WouterThys/PowerSupply/PCB/MainController/MainController.png

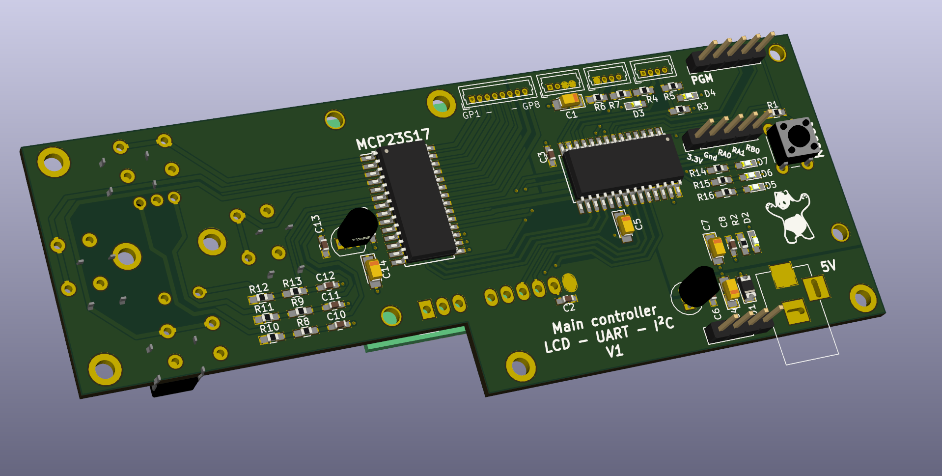
PCB/MainController/MainController.png
