WouterThys/PowerSupply/measurements.ods

 | Rout | 10000 |  |  | Vout divider: |  | 0.198 |  |  |  |  | A Sense: | 20 |  |  |  | All voltages in mV
 |  |  |  |  | Vref: |  | 2.048 |  |  |  |  | R Sense: | 0.1 |  |  |  | All currents in mA
send | dac |  | amp |  | 3081 |  |  |  |  |  | Feedback
 | should be | actual | should be | actual | should be | actual | Imon |  | temp |  | v divider | digital | should be | actual | should be | actual | measure
 |  |  |  |  | Vout |  | measure | calc | measure | calc | V |  |  |  | Iout |  |  |  |  | Values too high for correct working
10 | 20 | 20.6 | 80 | 87.6 | 80 | 522 |  | 0.00 |  |  | 103.36 |  |  | 502 | 0.05 | 0.00
50 | 100 | 100.7 | 400 | 418 | 400 | 537 |  | 0.00 |  |  | 106.33 |  |  | 517 | 0.05 | 0.00
100 | 200 | 201.2 | 800 | 828 | 800 | 828 |  | 0.00 |  |  | 163.94 |  |  | 807 | 0.08 | 0.50 | 2 | 4.6 | Minimum load current needed to operate
200 | 400 | 401 | 1600 | 1634 | 1600 | 1635 |  | 0.00 |  |  | 323.73 |  |  | 1608 | 0.16 | 1.75 | 7 | 7.4
300 | 600 | 602 | 2400 | 2436 | 2400 | 2436 | 0.30 | 0.18 | 490.00 |  | 482.33 |  |  | 2403 | 0.24 | 3.00 | 12 | 9.5
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
