WouterThys/PowerSupply/CalibrationResults.ods

Des | Cal | Cur | Error
400 | 400 | 6 | 0
800 | 800 | 12 | 0
1200 | 1200 | 16 | 0
1600 | 1600 | 20 | 0
2000 | 2000 | 24 | 0
2400 | 2400 | 29 | 0
2800 | 2796 | 33 | 4
3200 | 3196 | 38 | 4
3600 | 3592 | 42 | 8
4000 | 3996 | 46 | 4
