WouterThys/PowerSupply/PCB/V3/MainController.pdf

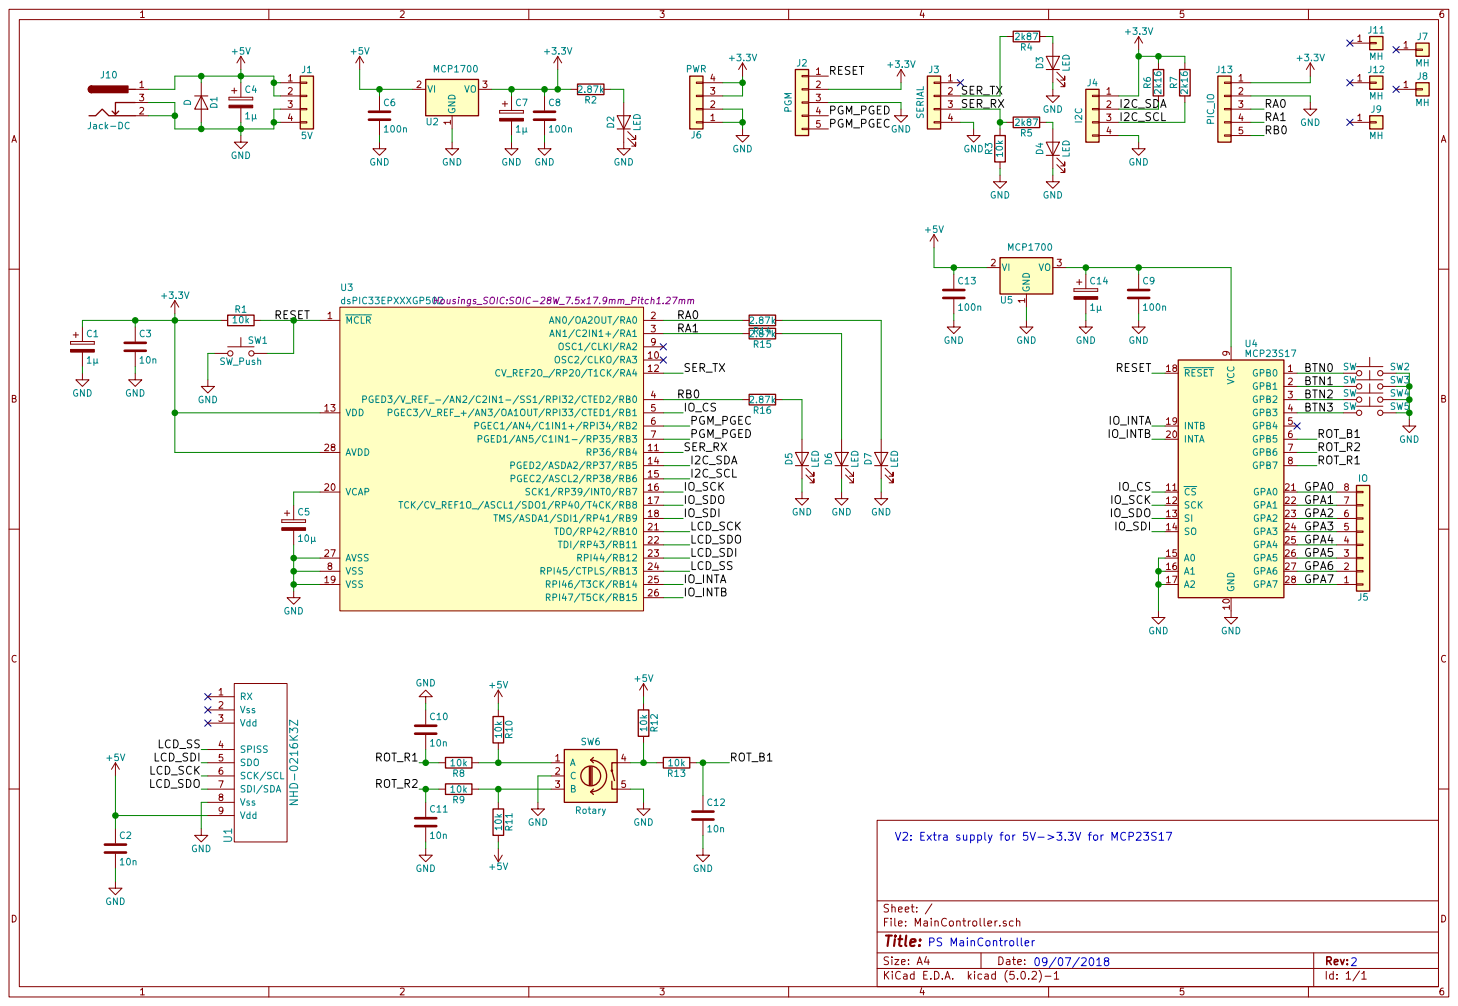
[picture p6: page 1]

Id: 1/1 Title: File: MainController.sch Sheet: /
