WouterThys/PowerSupply/PCB/MainGLCDController/MainGLCDController/MainGLCDController.kicad_pcb

## KiCad design PCB/MainGLCDController/MainGLCDController/MainGLCDController.kicad_pcb (2020-05-08)

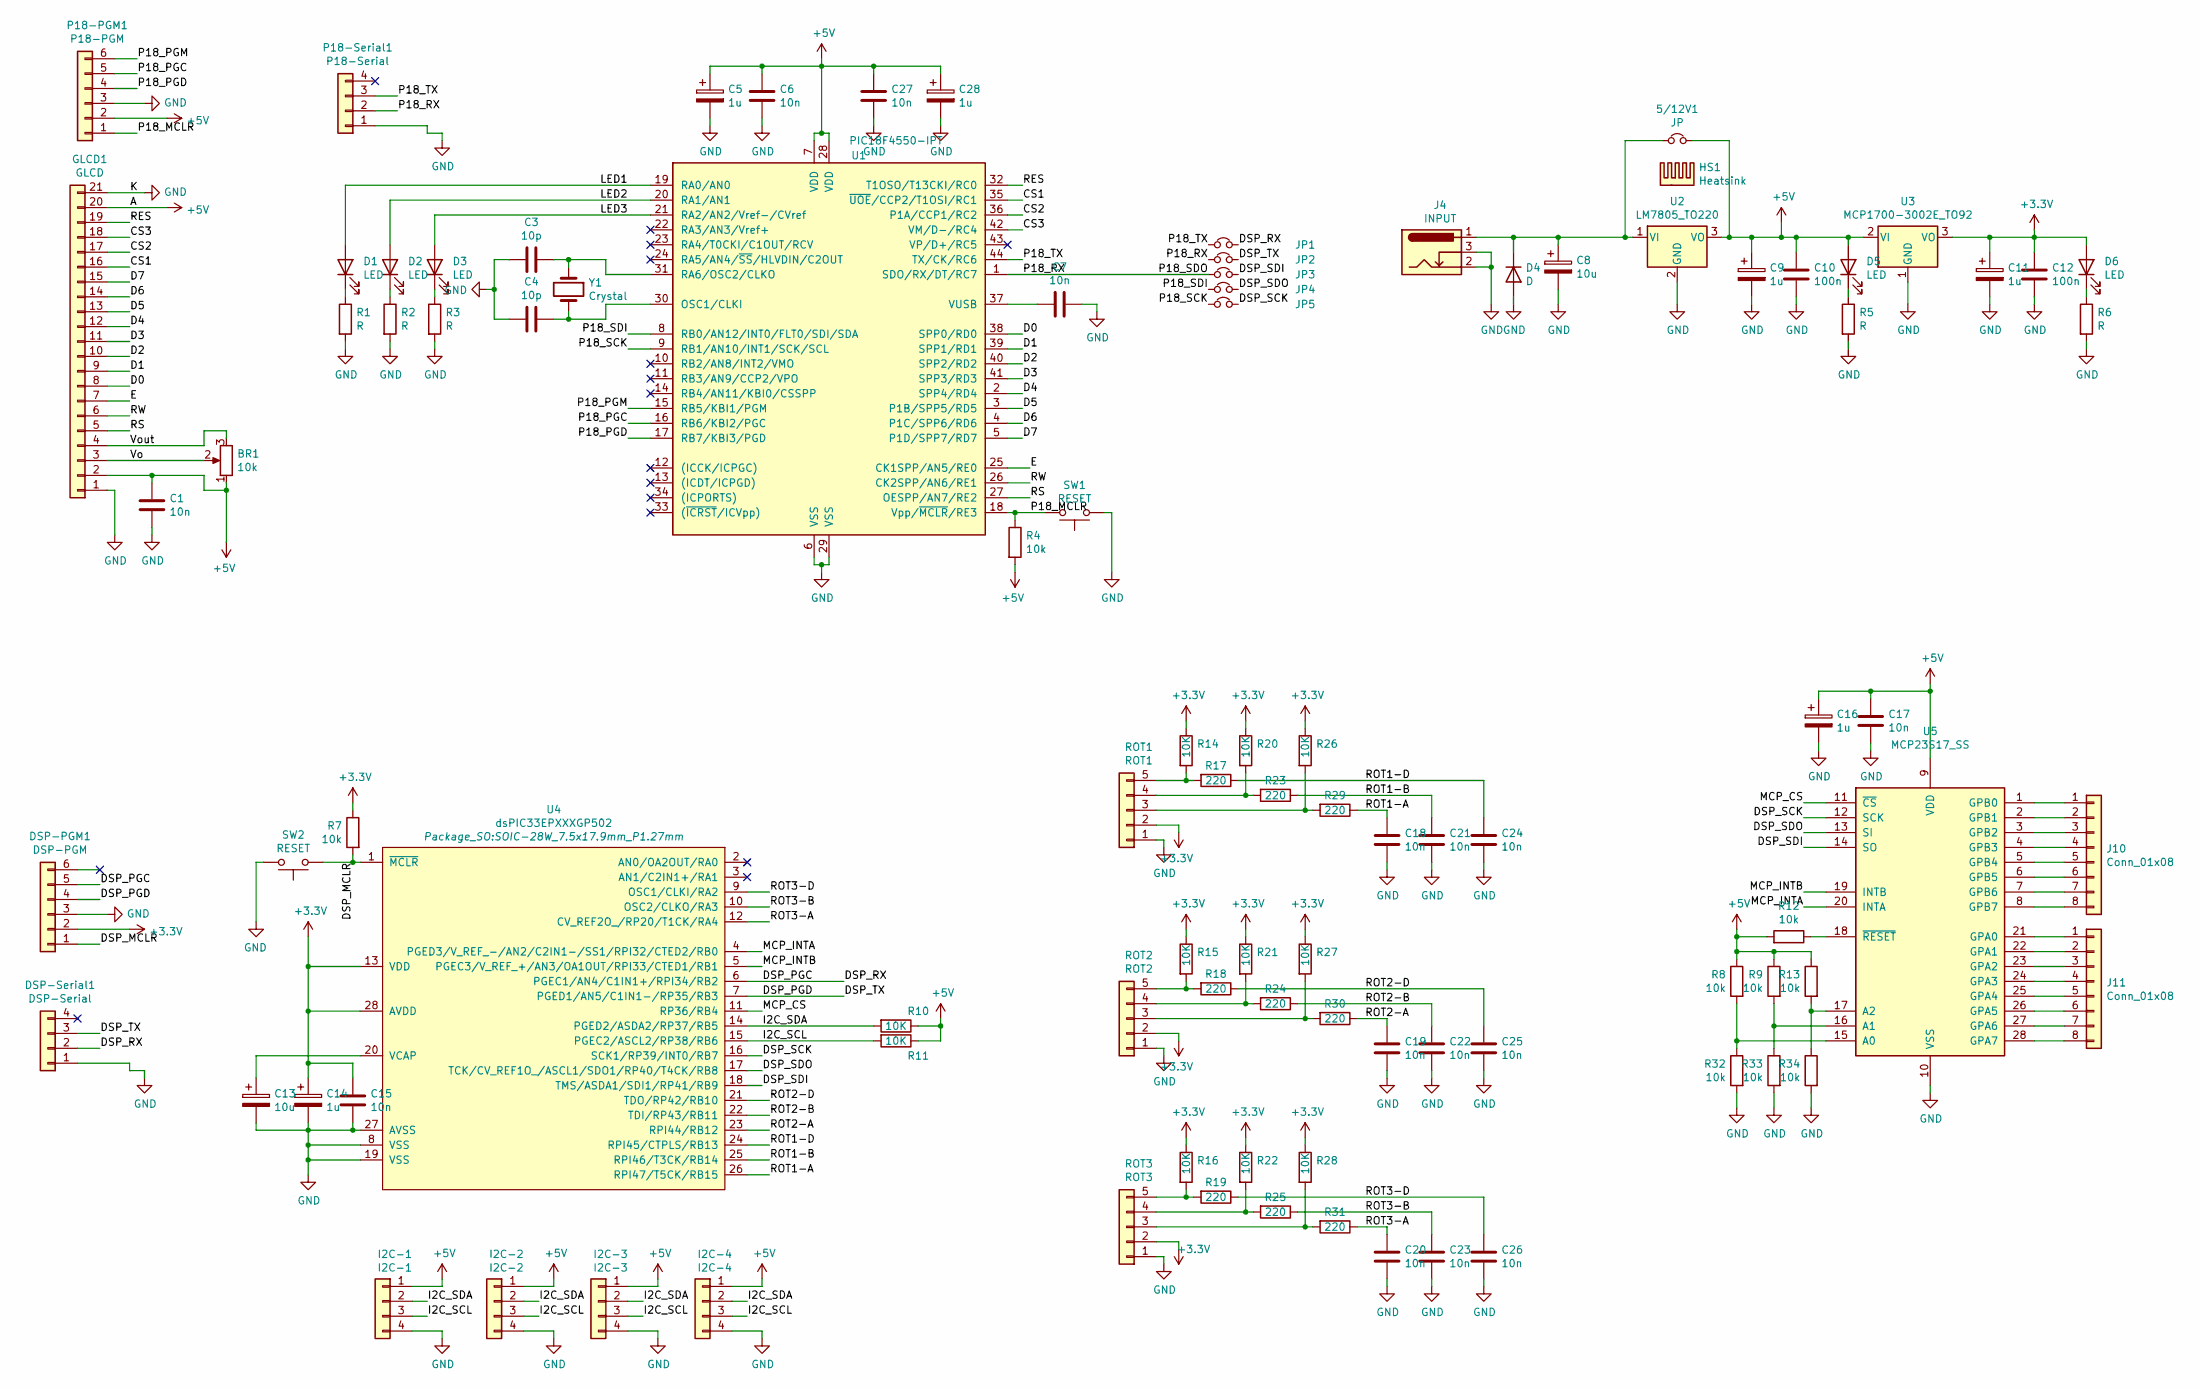
[picture p7: schematic MainGLCDController.sch]

Parts:
5/12V1: JP; PinHeader_1x02_P2.54mm_Vertical
BR1: 10k; Potentiometer_Vishay_T73YP_Vertical
C1, C6, C7, C15, C17, C18, C19, C20, C21, C22, C23, C24, C25, C26, C27: 10n; C_0603_1608Metric_Pad1.05x0.95mm_HandSolder
C3, C4: 10p; C_0603_1608Metric_Pad1.05x0.95mm_HandSolder
C5, C9, C11, C14, C16, C28: 1u; CP_EIA-3216-18_Kemet-A_Pad1.58x1.35mm_HandSolder
C8, C13: 10u; CP_EIA-3216-18_Kemet-A_Pad1.58x1.35mm_HandSolder
C10, C12: 100n; C_0603_1608Metric_Pad1.05x0.95mm_HandSolder
D1, D2, D3, D5, D6: LED; LED_0603_1608Metric_Pad1.05x0.95mm_HandSolder
D4: D; D_DO-15_P12.70mm_Horizontal
DSP-PGM1: DSP-PGM; PinHeader_1x06_P2.54mm_Vertical
DSP-Serial1: DSP-Serial; PinHeader_1x04_P1.27mm_Vertical
GLCD1: GLCD; PinHeader_1x21_P1.27mm_Vertical
HS1: Heatsink; Heatsink_Fischer_SK104-STCB_35x13mm__2xDrill3.5mm_ScrewM3
I2C-1: I2C-1; PinHeader_1x04_P1.27mm_Vertical
I2C-2: I2C-2; PinHeader_1x04_P1.27mm_Vertical
I2C-3: I2C-3; PinHeader_1x04_P1.27mm_Vertical
I2C-4: I2C-4; PinHeader_1x04_P1.27mm_Vertical
J4: INPUT; BarrelJack_Horizontal
J10, J11: Conn_01x08; PinHeader_1x08_P1.27mm_Vertical
JP1, JP2, JP3, JP4, JP5: JP; PinHeader_1x02_P2.54mm_Vertical
P18-PGM1: P18-PGM; PinHeader_1x06_P2.54mm_Vertical
P18-Serial1: P18-Serial; PinHeader_1x04_P1.27mm_Vertical
R1, R2, R3, R5, R6: R; R_0603_1608Metric_Pad1.05x0.95mm_HandSolder
R4, R7, R8, R9, R12, R13, R32, R33, R34: 10k; R_0603_1608Metric_Pad1.05x0.95mm_HandSolder
R10, R11, R14, R15, R16, R20, R21, R22, R26, R27, R28: 10K; R_0603_1608Metric_Pad1.05x0.95mm_HandSolder
R17, R18, R19, R23, R24, R25, R29, R30, R31: 220; R_0603_1608Metric_Pad1.05x0.95mm_HandSolder
ROT1: ROT1; PinHeader_1x05_P1.27mm_Vertical
ROT2: ROT2; PinHeader_1x05_P1.27mm_Vertical
ROT3: ROT3; PinHeader_1x05_P1.27mm_Vertical
SW1, SW2: RESET; SW_PUSH_6mm_H4.3mm
U1: PIC18F4550-IPT; TQFP-44_10x10mm_P0.8mm
U2: LM7805_TO220; TO-220-3_Vertical
U3: MCP1700-3002E_TO92; TO-92_Inline
U4: dsPIC33EPXXXGP502; SOIC-28W_7.5x17.9mm_P1.27mm
U5: MCP23S17_SS; SSOP-28_5.3x10.2mm_P0.65mm
Y1: Crystal; Crystal_HC18-U_Vertical

Connections:
+3V3: C11.1, C12.1, C14.1, C15.1, D6.2 (A), DSP-PGM1.2, R7.1, R14.1, R15.1, R16.1, R20.1, R21.1, R22.1, R26.1, R27.1, R28.1, ROT1.2, ROT2.2, ROT3.2, U3.3 (VO), U4.13 (VDD), U4.28 (AVDD)
+5V: 5/12V1.2, BR1.1, C1.1, C5.1, C6.1, C9.1, C10.1, C16.1, C17.1, C27.1, C28.1, D5.2 (A), GLCD1.2, GLCD1.20, I2C-1.1, I2C-2.1, I2C-3.1, I2C-4.1, P18-PGM1.2, R4.2, R8.1, R9.1, R10.1, R11.1, R12.2, R13.1, U1.7 (VDD), U1.28 (VDD), U2.3 (VO), U3.2 (VI), U5.9 (VDD)
/CS1: GLCD1.16, U1.35 (~UOE~/CCP2/T1OSI/RC1)
/CS2: GLCD1.17, U1.36 (P1A/CCP1/RC2)
/CS3: GLCD1.18, U1.42 (VM/D-/RC4)
/D0: GLCD1.8, U1.38 (SPP0/RD0)
/D1: GLCD1.9, U1.39 (SPP1/RD1)
/D2: GLCD1.10, U1.40 (SPP2/RD2)
/D3: GLCD1.11, U1.41 (SPP3/RD3)
/D4: GLCD1.12, U1.2 (SPP4/RD4)
/D5: GLCD1.13, U1.3 (P1B/SPP5/RD5)
/D6: GLCD1.14, U1.4 (P1C/SPP6/RD6)
/D7: GLCD1.15, U1.5 (P1D/SPP7/RD7)
/DSP_MCLR: DSP-PGM1.1, R7.2, SW2.2, U4.1 (~MCLR)
/DSP_PGC: DSP-PGM1.5, DSP-Serial1.2, JP1.2, U4.6 (PGEC1/AN4/C1IN1+/RPI34/RB2)
/DSP_PGD: DSP-PGM1.4, DSP-Serial1.3, JP2.2, U4.7 (PGED1/AN5/C1IN1-/RP35/RB3)
/DSP_SCK: JP5.2, U4.16 (SCK1/RP39/INT0/RB7), U5.12 (SCK)
/DSP_SDI: JP3.2, U4.18 (TMS/ASDA1/SDI1/RP41/RB9), U5.14 (SO)
/DSP_SDO: JP4.2, U4.17 (TCK/CV_REF1O_/ASCL1/SDO1/RP40/T4CK/RB8), U5.13 (SI)
/E: GLCD1.7, U1.25 (CK1SPP/AN5/RE0)
/I2C_SCL: I2C-1.3, I2C-2.3, I2C-3.3, I2C-4.3, R11.2, U4.15 (PGEC2/ASCL2/RP38/RB6)
/I2C_SDA: I2C-1.2, I2C-2.2, I2C-3.2, I2C-4.2, R10.2, U4.14 (PGED2/ASDA2/RP37/RB5)
/LED1: D1.2 (A), U1.19 (RA0/AN0)
/LED2: D2.2 (A), U1.20 (RA1/AN1)
/LED3: D3.2 (A), U1.21 (RA2/AN2/Vref-/CVref)
/MCP_CS: U4.11 (RP36/RB4), U5.11 (~CS~)
/MCP_INTA: U4.4 (PGED3/V_REF_-/AN2/C2IN1-/SS1/RPI32/CTED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), U5.20 (INTA)
/MCP_INTB: U4.5 (PGEC3/V_REF_+/AN3/OA1OUT/RPI33/CTED1/RB1), U5.19 (INTB)
/P18_MCLR: P18-PGM1.1, R4.1, SW1.2, U1.18 (Vpp/~MCLR~/RE3)
/P18_PGC: P18-PGM1.5, U1.16 (RB6/KBI2/PGC)
/P18_PGD: P18-PGM1.4, U1.17 (RB7/KBI3/PGD)
/P18_PGM: P18-PGM1.6, U1.15 (RB5/KBI1/PGM)
/P18_RX: JP2.1, JP3.1, P18-Serial1.2, U1.1 (SDO/RX/DT/RC7)
/P18_SCK: JP5.1, U1.9 (RB1/AN10/INT1/SCK/SCL)
/P18_SDI: JP4.1, U1.8 (RB0/AN12/INT0/FLT0/SDI/SDA)
/P18_TX: JP1.1, P18-Serial1.3, U1.44 (TX/CK/RC6)
/RES: GLCD1.19, U1.32 (T1OSO/T13CKI/RC0)
/ROT1-A: C18.1, R29.1, U4.26 (RPI47/T5CK/RB15)
/ROT1-B: C21.1, R23.1, U4.25 (RPI46/T3CK/RB14)
/ROT1-D: C24.1, R17.1, U4.24 (RPI45/CTPLS/RB13)
/ROT2-A: C19.1, R30.1, U4.23 (RPI44/RB12)
/ROT2-B: C22.1, R24.1, U4.22 (TDI/RP43/RB11)
/ROT2-D: C25.1, R18.1, U4.21 (TDO/RP42/RB10)
/ROT3-A: C20.1, R31.1, U4.12 (CV_REF2O_/RP20/T1CK/RA4)
/ROT3-B: C23.1, R25.1, U4.10 (OSC2/CLKO/RA3)
/ROT3-D: C26.1, R19.1, U4.9 (OSC1/CLKI/RA2)
/RS: GLCD1.5, U1.27 (OESPP/AN7/RE2)
/RW: GLCD1.6, U1.26 (CK2SPP/AN6/RE1)
/Vo: BR1.2, GLCD1.3
/Vout: BR1.3, GLCD1.4
GND: C1.2, C3.2, C4.2, C5.2, C6.2, C7.1, C8.2, C9.2, C10.2, C11.2, C12.2, C13.2, C14.2, C15.2, C16.2, C17.2, C18.2, C19.2, C20.2, C21.2, C22.2, C23.2, C24.2, C25.2, C26.2, C27.2, C28.2, D4.2 (A), DSP-PGM1.3, DSP-Serial1.1, GLCD1.1, GLCD1.21, I2C-1.4, I2C-2.4, I2C-3.4, I2C-4.4, J4.2, J4.3, P18-PGM1.3, P18-Serial1.1, R1.2, R2.2, R3.2, R5.2, R6.2, R32.2, R33.2, R34.2, ROT1.1, ROT2.1, ROT3.1, SW1.1, SW2.1, U1.6 (VSS), U1.29 (VSS), U2.2 (GND), U3.1 (GND), U4.8 (VSS), U4.19 (VSS), U4.27 (AVSS), U5.10 (VSS)
unnamed: 5/12V1.1, C8.1, D4.1 (K), J4.1, U2.1 (VI)
unnamed: C3.1, U1.31 (RA6/OSC2/CLKO), Y1.1
unnamed: C4.1, U1.30 (OSC1/CLKI), Y1.2
unnamed: C7.2, U1.37 (VUSB)
unnamed: C13.1, U4.20 (VCAP)
unnamed: D1.1 (K), R1.1
unnamed: D2.1 (K), R2.1
unnamed: D3.1 (K), R3.1
unnamed: D5.1 (K), R5.1
unnamed: D6.1 (K), R6.1
unnamed: J10.1, U5.1 (GPB0)
unnamed: J10.2, U5.2 (GPB1)
unnamed: J10.3, U5.3 (GPB2)
unnamed: J10.4, U5.4 (GPB3)
unnamed: J10.5, U5.5 (GPB4)
unnamed: J10.6, U5.6 (GPB5)
unnamed: J10.7, U5.7 (GPB6)
unnamed: J10.8, U5.8 (GPB7)
unnamed: J11.1, U5.21 (GPA0)
unnamed: J11.2, U5.22 (GPA1)
unnamed: J11.3, U5.23 (GPA2)
unnamed: J11.4, U5.24 (GPA3)
unnamed: J11.5, U5.25 (GPA4)
unnamed: J11.6, U5.26 (GPA5)
unnamed: J11.7, U5.27 (GPA6)
unnamed: J11.8, U5.28 (GPA7)
unnamed: R12.1, U5.18 (~RESET~)
unnamed: R13.2, R34.1, U5.17 (A2)
unnamed: R14.2, R17.2, ROT1.5
unnamed: R15.2, R18.2, ROT2.5
unnamed: R16.2, R19.2, ROT3.5
unnamed: R20.2, R23.2, ROT1.4
unnamed: R21.2, R24.2, ROT2.4
unnamed: R22.2, R25.2, ROT3.4
unnamed: R26.2, R29.2, ROT1.3
unnamed: R27.2, R30.2, ROT2.3
unnamed: R28.2, R31.2, ROT3.3
unnamed: R8.2, R32.1, U5.15 (A0)
unnamed: R9.2, R33.1, U5.16 (A1)

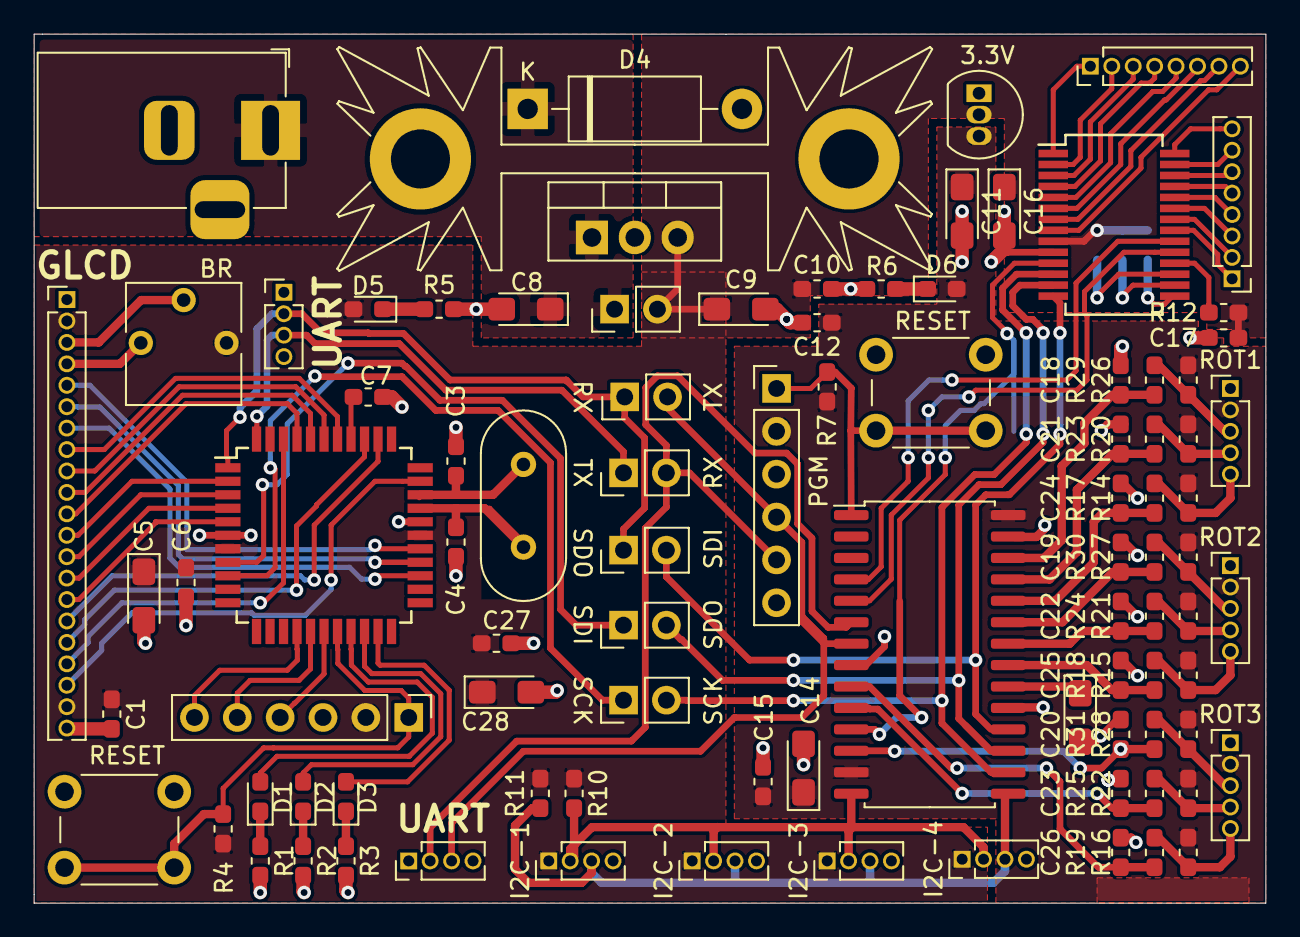
[picture p8: board MainGLCDController.kicad_pcb from above]

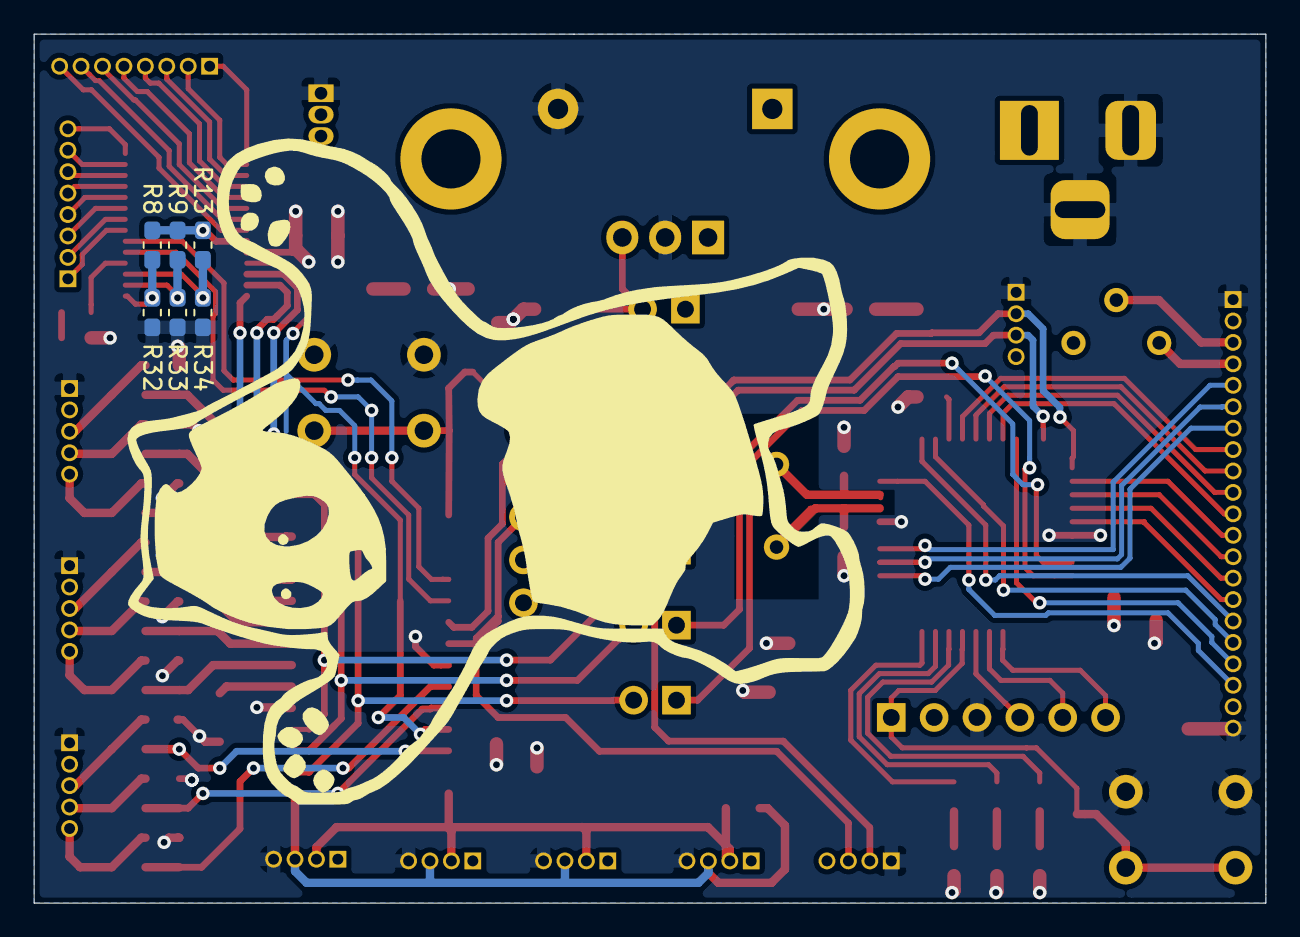
[picture p9: board MainGLCDController.kicad_pcb from below]

Board: 2 copper layers, 73.0 x 51.5 mm, 98 parts (6 on the bottom side), 90 nets.
