WouterThys/PowerSupply/PCB/MainController/MainController.kicad_pcb

## KiCad design PCB/MainController/MainController.kicad_pcb (2018-07-30)

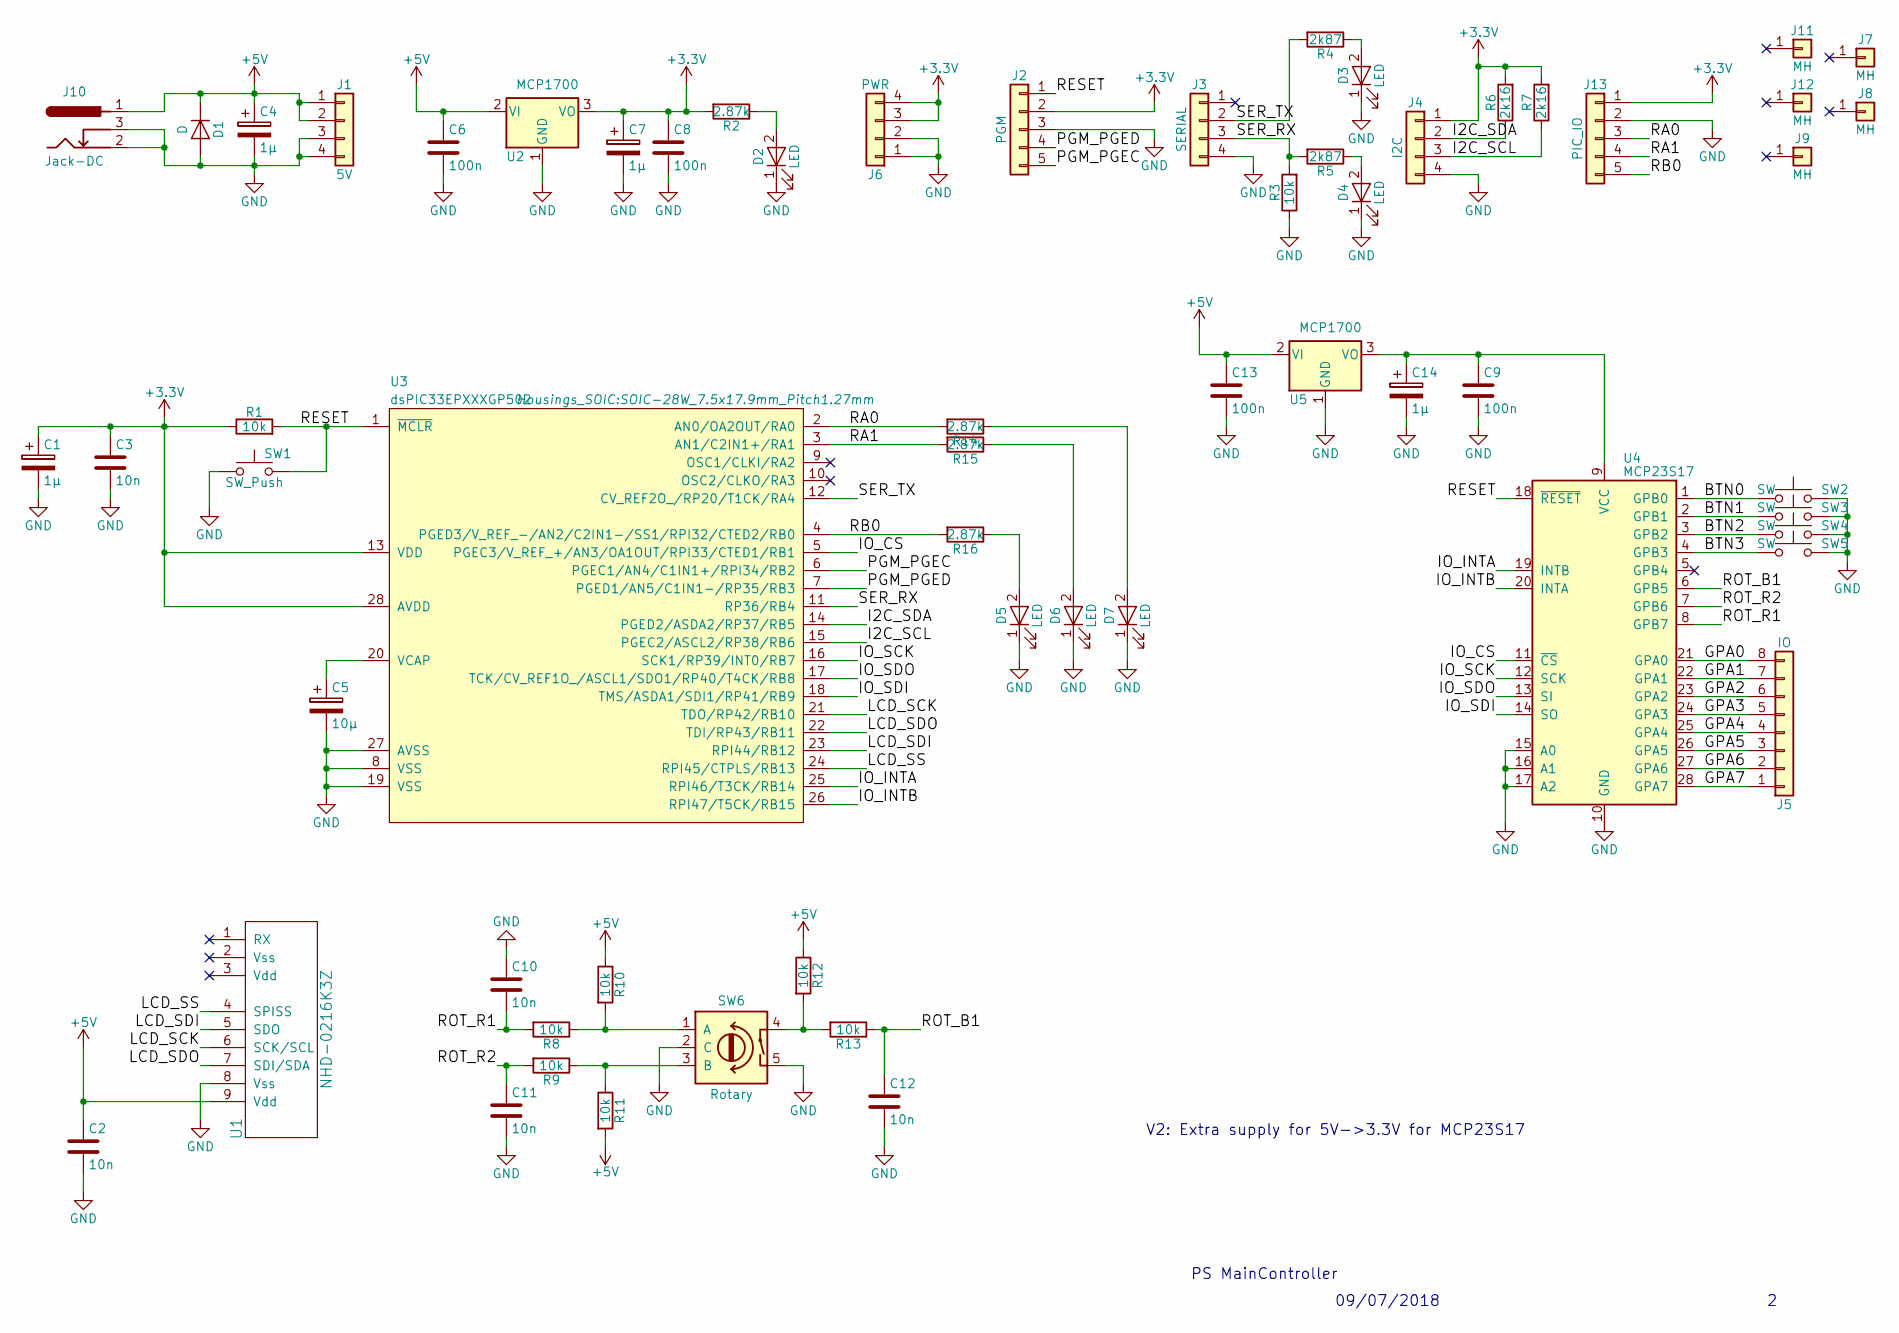
[picture p10: schematic MainController.sch]

Parts:
C1, C4, C7, C14: 1µ; CP_Tantalum_Case-A_EIA-3216-18_Reflow
C2, C3, C10, C11, C12: 10n; C_0603_HandSoldering
C5: 10µ; CP_Tantalum_Case-A_EIA-3216-18_Reflow
C6, C8, C9, C13: 100n; C_0603_HandSoldering
D1: D; D_1206
D2, D3, D4, D5, D6, D7: LED; LED_0603_HandSoldering
J1: 5V; Pin_Header_Straight_1x04_Pitch2.54mm
J2: PGM; Pin_Header_Straight_1x05_Pitch2.54mm
J3: SERIAL; Molex_PicoBlade_53047-0410_04x1.25mm_Straight
J4: I2C; Molex_PicoBlade_53047-0410_04x1.25mm_Straight
J5: IO; Molex_PicoBlade_53047-0810_08x1.25mm_Straight
J6: PWR; Molex_PicoBlade_53047-0410_04x1.25mm_Straight
J7, J8, J9, J11, J12: MH; MountingHole_2.7mm_M2.5_ISO14580_Pad
J10: Jack-DC; BARREL_JACK
J13: PIC_IO; Pin_Header_Straight_1x05_Pitch2.54mm
R1, R3, R8, R9, R10, R11, R12, R13: 10k; R_0603_HandSoldering
R2, R14, R15, R16: 2.87k; R_0603_HandSoldering
R4, R5: 2k87; R_0603_HandSoldering
R6, R7: 2k16; R_0603_HandSoldering
SW1: SW_Push; SW_PUSH_6mm
SW2, SW3, SW4, SW5: SW; mySW_PUSH_6mm
SW6: Rotary; ALPS_STEC12E08
U1: NHD-0216K3Z; WC1602A
U2, U5: MCP1700; TO-92_Inline_Narrow_Oval
U3: dsPIC33EPXXXGP502; SOIC-28W_7.5x17.9mm_Pitch1.27mm
U4: MCP23S17; SOIC-28W_7.5x17.9mm_Pitch1.27mm

Connections:
+3V3: C1.1, C3.1, C7.1, C8.1, J2.2, J4.1, J6.3, J6.4, J13.1, R1.1, R2.2, R6.2, R7.2, U2.3 (VO), U3.13 (VDD), U3.28 (AVDD)
+5V: C2.1, C4.1, C6.1, C13.1, D1.1 (K), J1.1, J1.2, J10.1, R10.1, R11.2, R12.1, U1.9 (Vdd), U2.2 (VI), U5.2 (VI)
/BTN0: SW2.1, U4.1 (GPB0)
/BTN1: SW3.1, U4.2 (GPB1)
/BTN2: SW4.1, U4.3 (GPB2)
/BTN3: SW5.1, U4.4 (GPB3)
/GPA0: J5.8, U4.21 (GPA0)
/GPA1: J5.7, U4.22 (GPA1)
/GPA2: J5.6, U4.23 (GPA2)
/GPA3: J5.5, U4.24 (GPA3)
/GPA4: J5.4, U4.25 (GPA4)
/GPA5: J5.3, U4.26 (GPA5)
/GPA6: J5.2, U4.27 (GPA6)
/GPA7: J5.1, U4.28 (GPA7)
/I2C_SCL: J4.3, R7.1, U3.15 (PGEC2/ASCL2/RP38/RB6)
/I2C_SDA: J4.2, R6.1, U3.14 (PGED2/ASDA2/RP37/RB5)
/IO_CS: U3.5 (PGEC3/V_REF_+/AN3/OA1OUT/RPI33/CTED1/RB1), U4.11 (~CS)
/IO_INTA: U3.25 (RPI46/T3CK/RB14), U4.19 (INTB)
/IO_INTB: U3.26 (RPI47/T5CK/RB15), U4.20 (INTA)
/IO_SCK: U3.16 (SCK1/RP39/INT0/RB7), U4.12 (SCK)
/IO_SDI: U3.18 (TMS/ASDA1/SDI1/RP41/RB9), U4.14 (SO)
/IO_SDO: U3.17 (TCK/CV_REF1O_/ASCL1/SDO1/RP40/T4CK/RB8), U4.13 (SI)
/LCD_SCK: U1.6 (SCK/SCL), U3.21 (TDO/RP42/RB10)
/LCD_SDI: U1.5 (SDO), U3.23 (RPI44/RB12)
/LCD_SDO: U1.7 (SDI/SDA), U3.22 (TDI/RP43/RB11)
/LCD_SS: U1.4 (SPISS), U3.24 (RPI45/CTPLS/RB13)
/PGM_PGEC: J2.5, U3.6 (PGEC1/AN4/C1IN1+/RPI34/RB2)
/PGM_PGED: J2.4, U3.7 (PGED1/AN5/C1IN1-/RP35/RB3)
/RA0: J13.3, R14.2, U3.2 (AN0/OA2OUT/RA0)
/RA1: J13.4, R15.2, U3.3 (AN1/C2IN1+/RA1)
/RB0: J13.5, R16.2, U3.4 (PGED3/V_REF_-/AN2/C2IN1-/SS1/RPI32/CTED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)
/RESET: J2.1, R1.2, SW1.2, U3.1 (~MCLR), U4.18 (~RESET)
/ROT_B1: C12.1, R13.1, U4.6 (GPB5)
/ROT_R1: C10.2, R8.2, U4.8 (GPB7)
/ROT_R2: C11.1, R9.2, U4.7 (GPB6)
/SER_RX: J3.3, R3.2, R5.2, U3.11 (RP36/RB4)
/SER_TX: J3.2, R4.2, U3.12 (CV_REF2O_/RP20/T1CK/RA4)
GND: C1.2, C2.2, C3.2, C4.2, C5.2, C6.2, C7.2, C8.2, C9.2, C10.1, C11.2, C12.2, C13.2, C14.2, D1.2 (A), D2.1 (K), D3.1 (K), D4.1 (K), D5.1 (K), D6.1 (K), D7.1 (K), J1.3, J1.4, J2.3, J3.4, J4.4, J6.1, J6.2, J10.2, J10.3, J13.2, R3.1, SW1.1, SW2.2, SW3.2, SW4.2, SW5.2, SW6.2 (C), SW6.5, U1.8 (Vss), U2.1 (GND), U3.8 (VSS), U3.19 (VSS), U3.27 (AVSS), U4.10 (GND), U4.15 (A0), U4.16 (A1), U4.17 (A2), U5.1 (GND)
unnamed: C5.1, U3.20 (VCAP)
unnamed: C9.1, C14.1, U4.9 (VCC), U5.3 (VO)
unnamed: D2.2 (A), R2.1
unnamed: D3.2 (A), R4.1
unnamed: D4.2 (A), R5.1
unnamed: D5.2 (A), R16.1
unnamed: D6.2 (A), R15.1
unnamed: D7.2 (A), R14.1
unnamed: R8.1, R10.2, SW6.1 (A)
unnamed: R9.1, R11.1, SW6.3 (B)
unnamed: R12.2, R13.2, SW6.4

Notes on the sheet:
V2: Extra supply for 5V->3.3V for MCP23S17
PS MainController
09/07/2018

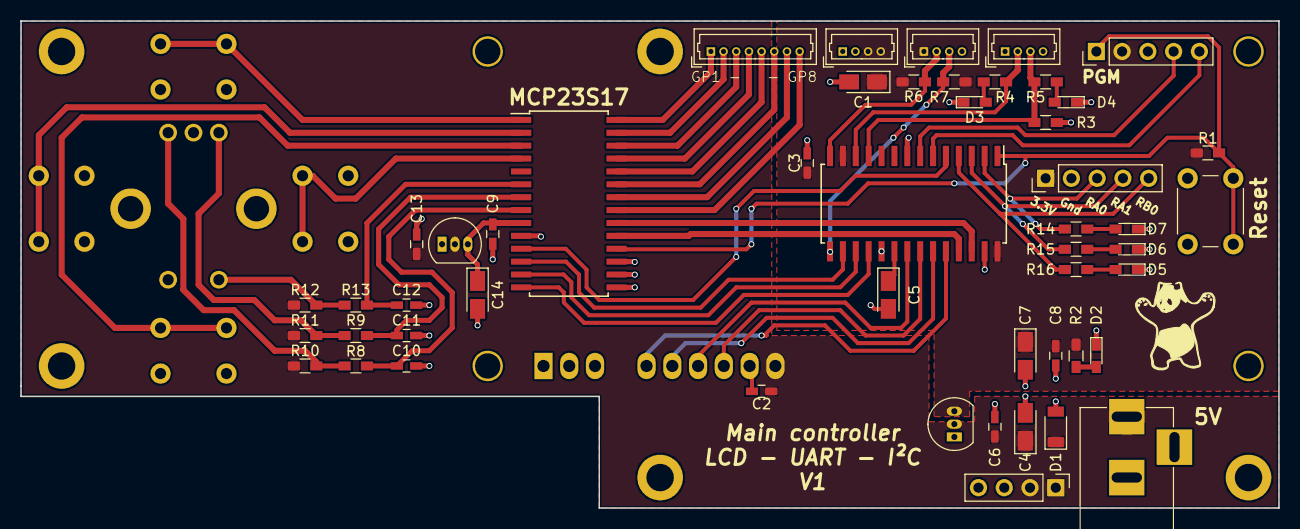
[picture p11: board MainController.kicad_pcb from above]

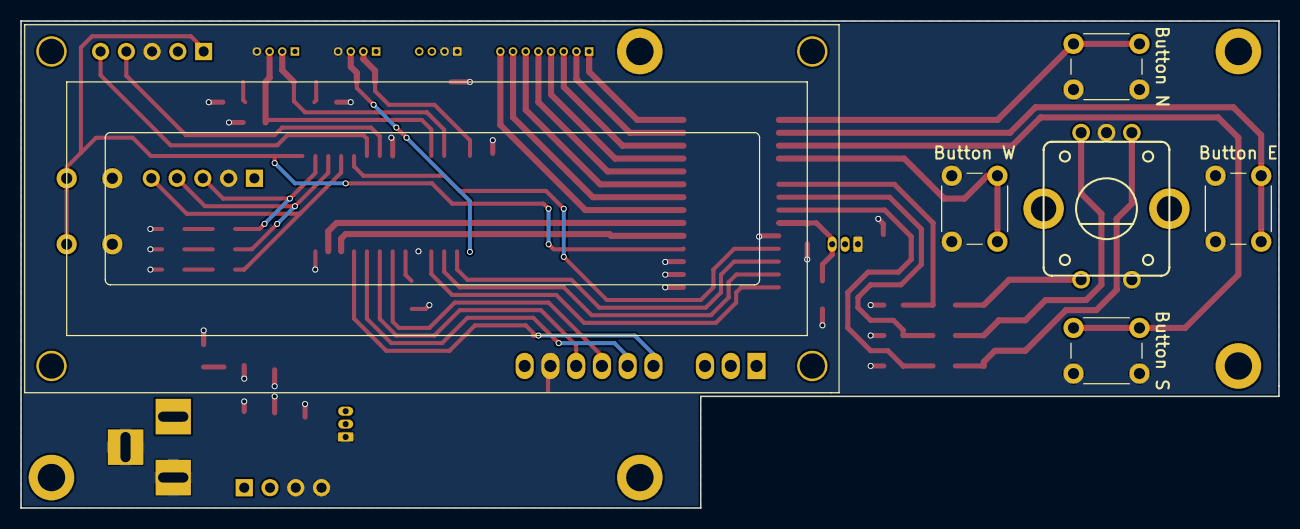
[picture p12: board MainController.kicad_pcb from below]

Board: 2 copper layers, 124.0 x 48.0 mm, 61 parts (6 on the bottom side), 49 nets.
