WouterThys/PowerSupply/PCB/V1/SupplyMainDigital.kicad_pcb

## KiCad design PCB/V1/SupplyMainDigital.kicad_pcb (2018-06-11, an earlier design)

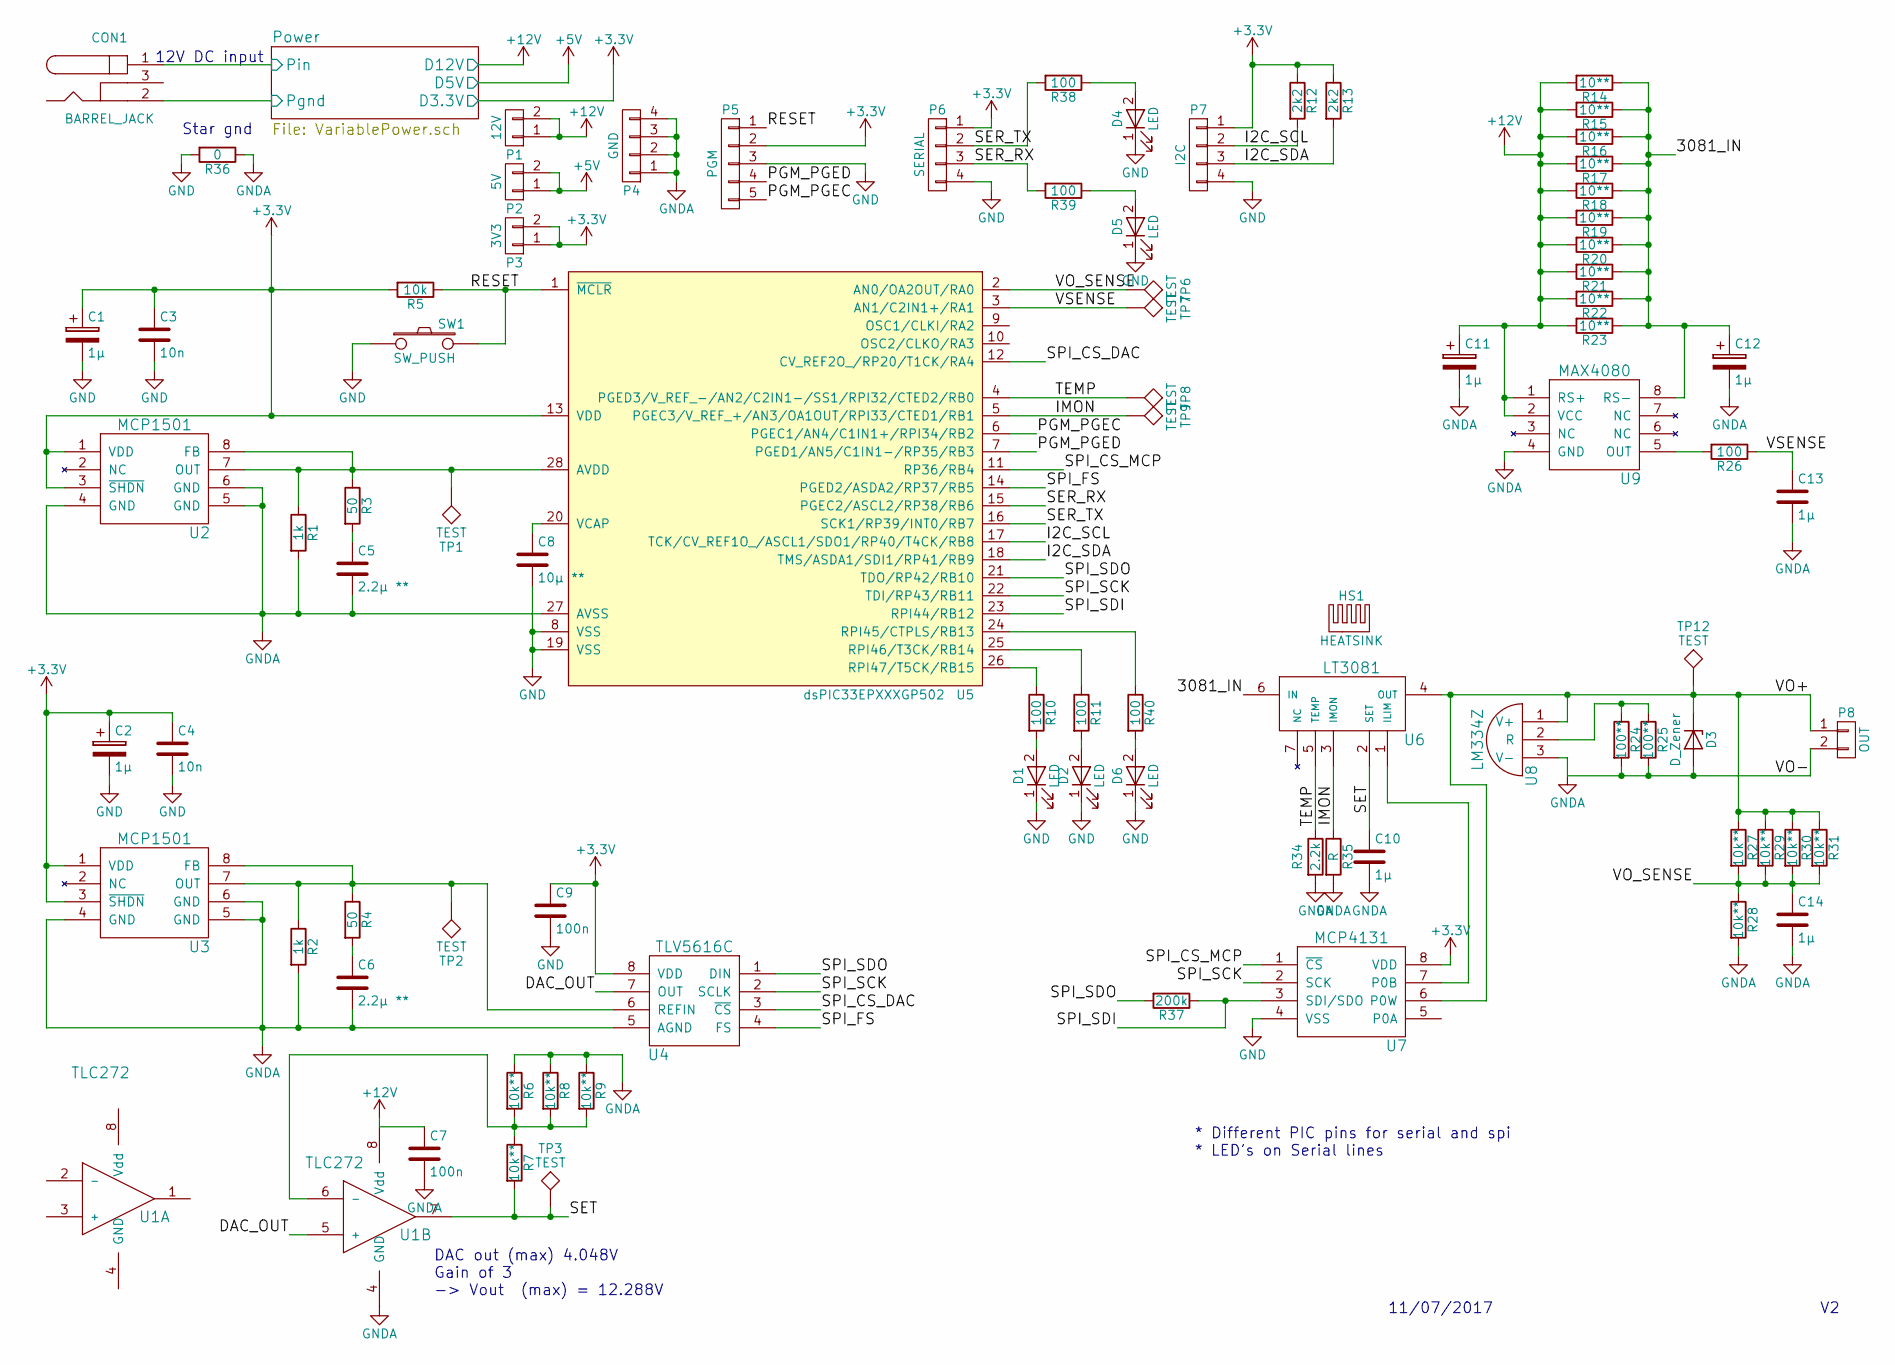
[picture p13: schematic SupplyMainDigital.sch]

Parts:
C1, C2, C10, C11, C12, C13, C14: 1µ; C_0603_HandSoldering
C3, C4: 10n; C_0603_HandSoldering
C5, C6: 2.2µ **; CP_Tantalum_Case-A_EIA-3216-18_Reflow
C7, C9: 100n; C_0603_HandSoldering
C8: 10µ **; CP_Tantalum_Case-A_EIA-3216-18_Reflow
CON1: BARREL_JACK
D1, D2, D4, D5, D6: LED; LED_0603
D3: D_Zener; D_5W_P10.16mm_Horizontal
HS1: HEATSINK; Heatsink_Fischer_SK104-STCB_35x13mm__2xDrill3.5mm_ScrewM3
P1: 12V; Pin_Header_Straight_1x02_Pitch2.54mm
P2: 5V; Pin_Header_Straight_1x02_Pitch2.54mm
P3: 3V3; Pin_Header_Straight_1x02_Pitch2.54mm
P4: GND; Pin_Header_Straight_1x04_Pitch2.54mm
P5: PGM; Pin_Header_Angled_1x05_Pitch2.00mm
P6: SERIAL; Molex_PicoBlade_53047-0410_04x1.25mm_Straight
P7: I2C; Molex_PicoBlade_53047-0410_04x1.25mm_Straight
P8: OUT; AK300-2
R1, R2: 1k; R_0603_HandSoldering
R3, R4: 50; R_0603_HandSoldering
R5: 10k; R_0603_HandSoldering
R6, R7, R8, R9, R27, R28, R29, R30, R31: 10k**; R_0603_HandSoldering
R10, R11, R26, R38, R39, R40: 100; R_0603_HandSoldering
R12, R13: 2k2; R_0603_HandSoldering
R14, R15, R16, R17, R18, R19, R20, R21, R22, R23: 10**; R_0805_HandSoldering
R24, R25: 100**; R_0603_HandSoldering
R34: 2.2k; R_0603_HandSoldering
R35: R; R_0603_HandSoldering
R36: 0; R_0603_HandSoldering
R37: 200k; R_0603_HandSoldering
SW1: SW_PUSH; SW_SPST_B3S-1000
TP1, TP2, TP3, TP6, TP7, TP8, TP9, TP12: TEST; Measurement_Point_Round-SMD-Pad_Small
U1: TLC272; TSSOP-8_4.4x3mm_Pitch0.65mm
U2, U3: MCP1501; SOIC-8_3.9x4.9mm_Pitch1.27mm
U4: TLV5616C; SOIC-8_3.9x4.9mm_Pitch1.27mm
U5: dsPIC33EPXXXGP502; SOIC-28W_7.5x17.9mm_Pitch1.27mm
U6: LT3081; TO-220-7_Multiwatt-7_Vertical_StaggeredType1
U7: MCP4131; MSOP-8_3x3mm_Pitch0.65mm
U8: LM334Z; TO-92_Inline_Narrow_Oval
U9: MAX4080; MSOP-8_3x3mm_Pitch0.65mm

Connections:
+3V3: C1.1, C2.1, C3.1, C4.1, C9.1, P3.1, P3.2, P5.2, P6.1, P7.1, R5.2, R12.1, R13.1, U2.1 (VDD), U2.3 (~SHDN), U3.1 (VDD), U3.3 (~SHDN), U4.8 (VDD), U5.13 (VDD), U7.8 (VDD); also elsewhere on the board
+5V: P2.1, P2.2; also elsewhere on the board
+12V: C7.1, C11.1, P1.1, P1.2, R14.2, R15.2, R16.2, R17.2, R18.2, R19.2, R20.2, R21.2, R22.2, R23.2, U1.8 (Vdd), U9.1 (RS+), U9.2 (VCC); also elsewhere on the board
/3081_IN: C12.1, R14.1, R15.1, R16.1, R17.1, R18.1, R19.1, R20.1, R21.1, R22.1, R23.1, U6.6 (IN), U9.8 (RS-)
/DAC_OUT: U1.5 (+), U4.7 (OUT)
/I2C_SCL: P7.2, R12.2, U5.17 (TCK/CV_REF1O_/ASCL1/SDO1/RP40/T4CK/RB8)
/I2C_SDA: P7.3, R13.2, U5.18 (TMS/ASDA1/SDI1/RP41/RB9)
/IMON: R35.1, TP9.1, U5.5 (PGEC3/V_REF_+/AN3/OA1OUT/RPI33/CTED1/RB1), U6.3 (IMON)
/PGM_PGEC: P5.5, U5.6 (PGEC1/AN4/C1IN1+/RPI34/RB2)
/PGM_PGED: P5.4, U5.7 (PGED1/AN5/C1IN1-/RP35/RB3)
/Power/Pin: CON1.1; also elsewhere on the board
/RESET: P5.1, R5.1, SW1.2, U5.1 (~MCLR)
/SER_RX: P6.3, R39.2, U5.15 (PGEC2/ASCL2/RP38/RB6)
/SER_TX: P6.2, R38.2, U5.16 (SCK1/RP39/INT0/RB7)
/SET: C10.1, R7.2, TP3.1, U1.7, U6.2 (SET)
/SPI_CS_DAC: U4.3 (~CS), U5.12 (CV_REF2O_/RP20/T1CK/RA4)
/SPI_CS_MCP: U5.11 (RP36/RB4), U7.1 (~CS)
/SPI_FS: U4.4 (FS), U5.14 (PGED2/ASDA2/RP37/RB5)
/SPI_SCK: U4.2 (SCLK), U5.22 (TDI/RP43/RB11), U7.2 (SCK)
/SPI_SDI: R37.1, U5.23 (RPI44/RB12), U7.3 (SDI/SDO)
/SPI_SDO: R37.2, U4.1 (DIN), U5.21 (TDO/RP42/RB10)
/TEMP: R34.1, TP8.1, U5.4 (PGED3/V_REF_-/AN2/C2IN1-/SS1/RPI32/CTED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), U6.5 (TEMP)
/VO+: D3.1 (K), P8.1, R27.1, R29.1, R30.1, R31.1, TP12.1, U6.4 (OUT), U7.6 (P0W), U8.1 (V+)
/VO_SENSE: C14.1, R27.2, R28.1, R29.2, R30.2, R31.2, TP6.1, U5.2 (AN0/OA2OUT/RA0)
/VSENSE: C13.1, R26.1, TP7.1, U5.3 (AN1/C2IN1+/RA1)
GND: C1.2, C2.2, C3.2, C4.2, C8.2, C9.2, D1.1 (K), D2.1 (K), D4.1 (K), D5.1 (K), D6.1 (K), P5.3, P6.4, P7.4, R36.2, SW1.1, U5.8 (VSS), U5.19 (VSS), U7.4 (VSS)
GNDA: C5.2, C6.2, C7.2, C10.2, C11.2, C12.2, C13.2, C14.2, CON1.2, D3.2 (A), P4.1, P4.2, P4.3, P4.4, P8.2, R1.2, R2.2, R6.1, R8.1, R9.1, R24.2, R25.2, R28.2, R34.2, R35.2, R36.1, U1.4 (GND), U2.4 (GND), U2.5 (GND), U2.6 (GND), U3.4 (GND), U3.5 (GND), U3.6 (GND), U4.5 (AGND), U5.27 (AVSS), U8.3 (V-), U9.4 (GND); also elsewhere on the board
unnamed: C5.1, R3.2
unnamed: C6.1, R4.2
unnamed: C8.1, U5.20 (VCAP)
unnamed: D1.2 (A), R10.2
unnamed: D2.2 (A), R11.2
unnamed: D4.2 (A), R38.1
unnamed: D5.2 (A), R39.1
unnamed: D6.2 (A), R40.2
unnamed: R1.1, R3.1, TP1.1, U2.7 (OUT), U2.8 (FB), U5.28 (AVDD)
unnamed: R2.1, R4.1, TP2.1, U3.7 (OUT), U3.8 (FB), U4.6 (REFIN)
unnamed: R6.2, R7.1, R8.2, R9.2, U1.6 (-)
unnamed: R10.1, U5.26 (RPI47/T5CK/RB15)
unnamed: R11.1, U5.25 (RPI46/T3CK/RB14)
unnamed: R24.1, R25.1, U8.2 (R)
unnamed: R26.2, U9.5 (OUT)
unnamed: R40.1, U5.24 (RPI45/CTPLS/RB13)
unnamed: U6.1 (ILIM), U7.7 (P0B)

Notes on the sheet:
DAC out (max) 4.048V Gain of 3 -> Vout (max) = 12.288V
Star gnd
11/07/2017
* Different PIC pins for serial and spi * LED's on Serial lines
12V DC input

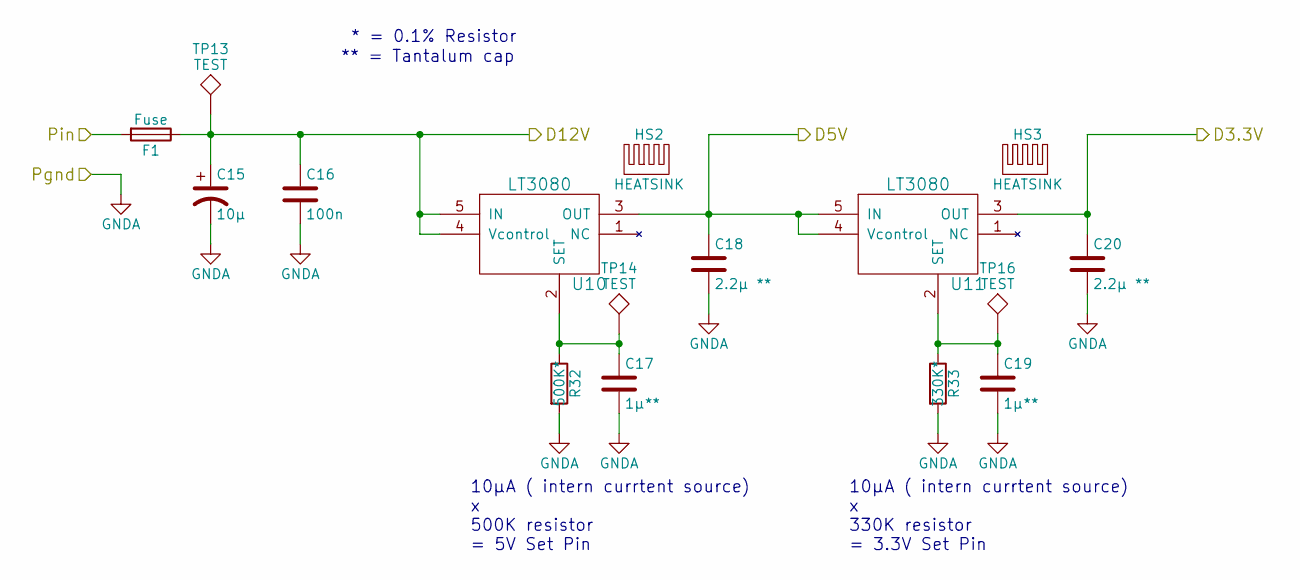
[picture p14: schematic VariablePower.sch]

Parts:
C15: 10µ; C_0603_HandSoldering
C16: 100n; C_0603_HandSoldering
C17, C19: 1µ**; CP_Tantalum_Case-A_EIA-3216-18_Reflow
C18, C20: 2.2µ **; CP_Tantalum_Case-A_EIA-3216-18_Reflow
F1: Fuse; Fuseholder5x20_horiz_SemiClosed_Casing10x25mm
HS2, HS3: HEATSINK; Heatsink_Fischer_SK104-STCB_35x13mm__2xDrill3.5mm_ScrewM3
R32: 500K*; R_0603_HandSoldering
R33: 330K*; R_0603_HandSoldering
TP13, TP14, TP16: TEST; Measurement_Point_Round-SMD-Pad_Small
U10, U11: LT3080; TO-220-5_Pentawatt_Multiwatt-5_Vertical_StaggeredType1

Connections:
+3V3: C20.1, U11.3 (OUT); also elsewhere on the board
+5V: C18.1, U10.3 (OUT), U11.4 (Vcontrol), U11.5 (IN); also elsewhere on the board
+12V: C15.1, C16.1, F1.1, TP13.1, U10.4 (Vcontrol), U10.5 (IN); also elsewhere on the board
/Power/Pin: F1.2; also elsewhere on the board
GNDA: C15.2, C16.2, C17.2, C18.2, C19.2, C20.2, R32.2, R33.2; also elsewhere on the board
unnamed: C17.1, R32.1, TP14.1, U10.2 (SET)
unnamed: C19.1, R33.1, TP16.1, U11.2 (SET)

Notes on the sheet:
* = 0.1% Resistor
** = Tantalum cap
10µA ( intern currtent source) x 500K resistor = 5V Set Pin
10µA ( intern currtent source) x 330K resistor = 3.3V Set Pin
