WouterThys/PowerSupply/PCB/V1/SupplyMainDigital.kicad_pcb

## KiCad design PCB/V1/SupplyMainDigital.kicad_pcb (continued)

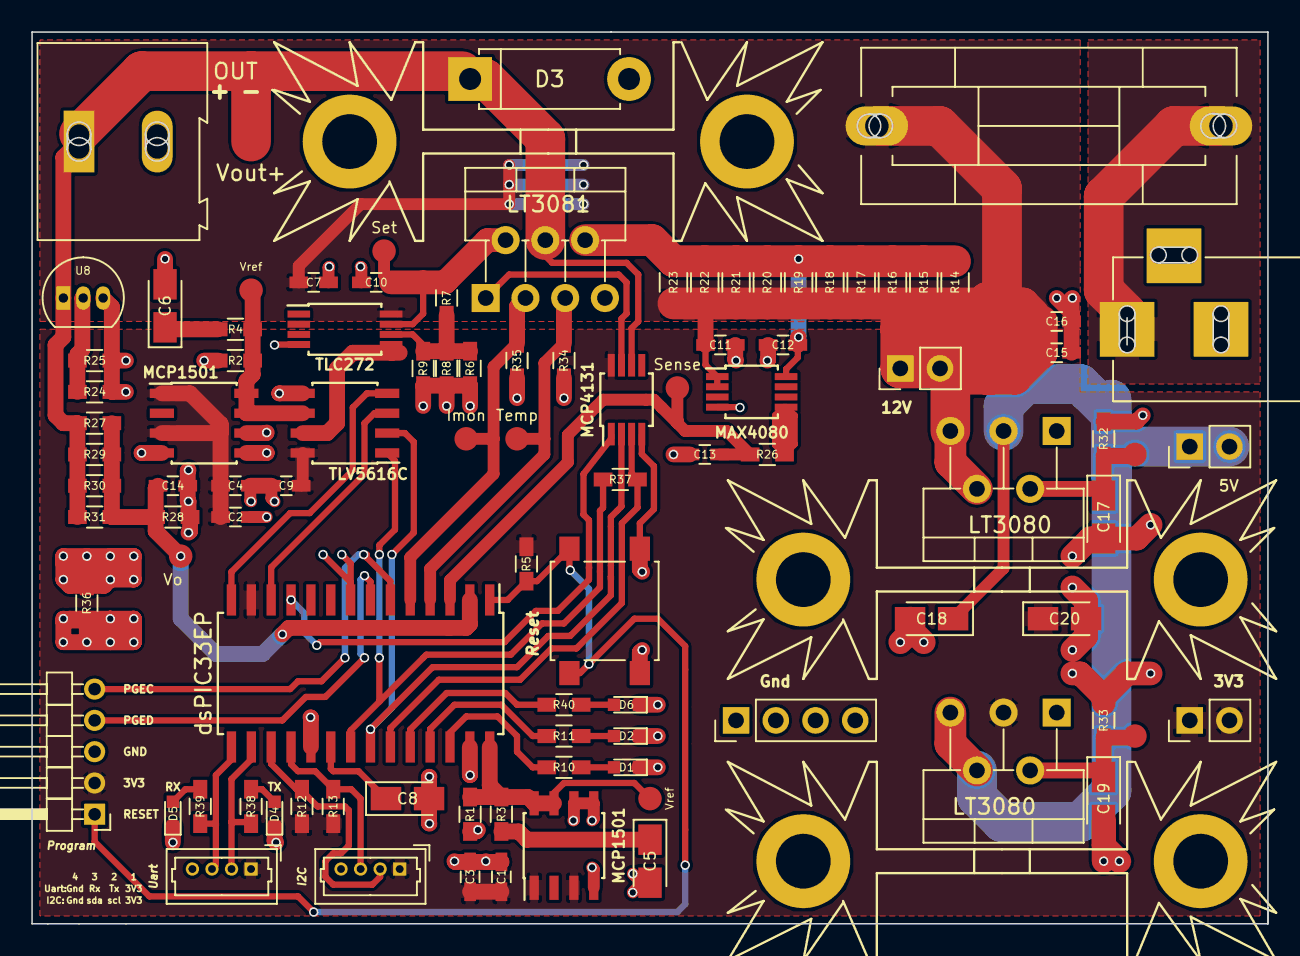
[picture p15: board PCB/V1/SupplyMainDigital.kicad_pcb from above]

Board: 2 copper layers, 79.0 x 57.0 mm, 102 parts (0 on the bottom side), 46 nets.
