WouterThys/PowerSupply/PCB/V3/SupplyMainDigital.kicad_pcb

## KiCad design PCB/V3/SupplyMainDigital.kicad_pcb (2018-06-11)

Schematic: SupplyMainDigital.sch, Power Supply

Parts:
C1, C2: 1µ; C_0603_HandSoldering
C3, C4: 10n; C_0603_HandSoldering
C5, C6: 2.2µ; CP_Tantalum_Case-A_EIA-3216-18_Hand
C7, C9, C11, C13, C14, C21, C22: 100n; C_0603_HandSoldering
C8, C10, C12, C23: 10µ; CP_Tantalum_Case-A_EIA-3216-18_Hand
C15, C16: 1µ; CP_Tantalum_Case-A_EIA-3216-18_Hand
D1, D2, D4, D5, D6, D7: LED; LED_0603_HandSoldering
D3: D_Zener; D_5W_P10.16mm_Horizontal
HS1: HEATSINK; Heatsink_Fischer_SK104-STCB_35x13mm__2xDrill3.5mm_ScrewM3
J1: IN; BARREL_JACK
J2: 3.3V; Molex_PicoBlade_53047-0410_04x1.25mm_Straight
J3: OUT; BARREL_JACK
J4, J5, J6, J7: Conn_01x01; MountingHole_2.7mm_M2.5_ISO14580_Pad
JP3, JP6: Pin_Header_Straight_1x02_Pitch2.54mm
JP5: Ilim; Pin_Header_Straight_1x02_Pitch2.54mm
P1: LEDs; Molex_PicoBlade_53047-0410_04x1.25mm_Straight
P5: PGM; Pin_Header_Straight_1x05_Pitch2.54mm
P6: SERIAL; Molex_PicoBlade_53047-0410_04x1.25mm_Straight
P7: I2C; Molex_PicoBlade_53047-0410_04x1.25mm_Straight
Q1, Q2: 2N3904; TO-92_Molded_Narrow
R1: 2.2k; R_0603_HandSoldering
R2, R5, R6, R7, R8, R9, R25, R28, R30, R31, R33, R37, R41: 10k; R_0603_HandSoldering
R3, R4: 50; R_0603_HandSoldering
R10, R11, R38, R39, R40: 196; R_0603_HandSoldering
R12, R13: 2k2; R_0603_HandSoldering
R14, R15, R16, R17, R18, R19, R20, R21, R22, R23: 1; R_0805_HandSoldering
R24, R27: 100; R_0603_HandSoldering
R26, R29, R32, R36: 1k; R_0603_HandSoldering
R34: 68k; R_0603_HandSoldering
R35: 5.1k; R_0603_HandSoldering
SW1: SW_PUSH; SW_SPST_KMR2
U1, U12: TLC272; SOIC-8_3.9x4.9mm_Pitch1.27mm
U2, U3: MCP1501; SOIC-8_3.9x4.9mm_Pitch1.27mm
U4: MCP4922; SOIC-14_3.9x8.7mm_Pitch1.27mm
U5: dsPIC33EPXXXGP502; SOIC-28W_7.5x17.9mm_Pitch1.27mm
U6: LT3081; TO-220-7_Multiwatt-7_Vertical_StaggeredType1
U8: LM334Z; TO-92_Inline_Narrow_Oval
U9: MAX4080; MSOP-8_3x3mm_Pitch0.65mm

Connections:
+3V3: C1.1, C2.1, C3.1, C4.1, C9.1, C10.1, C16.1, J2.1, J2.2, P5.2, P7.1, R5.2, R12.1, R13.1, R29.1, U2.1, U2.3, U3.1, U3.3, U4.1, U4.9, U5.13
+12V: C7.1, C11.1, C14.1, C15.1, J1.1, R1.1, R14.2, R15.2, R16.2, R17.2, R18.2, R19.2, R20.2, R21.2, R22.2, R23.2, U1.8 (Vdd), U9.1, U9.2, U12.8
/3081_IN: C13.1, R14.1, R15.1, R16.1, R17.1, R18.1, R19.1, R20.1, R21.1, R22.1, R23.1, U6.6, U9.8
/CLIP: Q2.3, R29.2, U5.14
/I2C_SCL: P7.3, R13.2, U5.17
/I2C_SDA: P7.2, R12.2, U5.18
/IMON: R35.1, U5.5, U6.3
/Iset: U1.6 (-), U4.10
/PGM_PGEC: P5.5, U5.6
/PGM_PGED: P5.4, U5.7
/RESET: P5.1, R5.1, SW1.2, U5.1
/SER_RX: P6.3, R30.2, R39.2, U5.15
/SER_TX: P6.2, R38.2, U5.16
/SET: C12.1, R7.2, R27.2, U6.2
/SPI_CS_DAC: U4.3, U5.12
/SPI_SCK: U4.4, U5.22
/SPI_SDO: U4.5, U5.21
/TEMP: R34.1, U5.4, U6.5
/VO_SENSE: U5.2, U12.1, U12.2
/VSENSE: U1.5 (+), U5.3, U12.6, U12.7
/Vref_DAC: R4.1, U3.7, U3.8, U4.11, U4.13
/Vset: U1.3 (+), U4.14
GND: C1.2, C2.2, C3.2, C4.2, C5.2, C6.2, C7.2, C8.2, C9.2, C10.2, C11.2, C12.2, C13.2, C14.2, C15.2, C16.2, C21.2, C22.2, C23.2, D1.1, D2.1, D3.2, D4.1, D5.1, D6.1, D7.1, J1.2, J1.3, J2.3, J2.4, J3.2, J3.3, P1.1, P5.3, P6.4, P7.4, Q1.1, Q2.1, R8.2, R9.2, R24.2, R30.1, R31.1, R33.1, R34.2, R35.2, R37.1, R41.1, SW1.1, U1.4 (GND), U2.4, U2.5, U2.6, U3.4, U3.5, U3.6, U4.8, U4.12, U5.8, U5.19, U5.27, U8.3, U9.4, U12.4
unnamed: C5.1, R3.2
unnamed: C6.1, R4.2
unnamed: C8.1, U5.20
unnamed: C21.1, R32.1, U12.5
unnamed: C22.1, R36.2, U12.3
unnamed: C23.1, D3.1, J3.1, JP5.2, JP6.2, U6.4
unnamed: D1.2, R10.2
unnamed: D2.2, R11.2
unnamed: D4.2, R38.1
unnamed: D5.2, R39.1
unnamed: D6.2, R40.2
unnamed: D7.2, R1.2
unnamed: JP3.1, Q1.3
unnamed: JP3.2, R26.2, R27.1
unnamed: JP5.1, U8.1
unnamed: JP6.1, R2.2
unnamed: P1.2, R10.1, U5.26
unnamed: P1.3, R11.1, U5.25
unnamed: P1.4, R40.1, U5.24
unnamed: Q1.2, R25.2
unnamed: Q2.2, R28.2
unnamed: R2.1, R31.2, R33.2, R36.1, R37.2, R41.2
unnamed: R3.1, U2.7, U2.8, U5.28
unnamed: R6.1, R8.1, R9.1, U1.2 (-)
unnamed: R6.2, R7.1
unnamed: R24.1, U8.2
unnamed: R25.1, R28.1, U1.7
unnamed: R26.1, U1.1
unnamed: R32.2, U9.5

Notes on the sheet:
Gain of 5 DAC out (max) 2.048V -> Vout (max) = 10.24V
LPF
Vout
LIM
Gain of 1/5

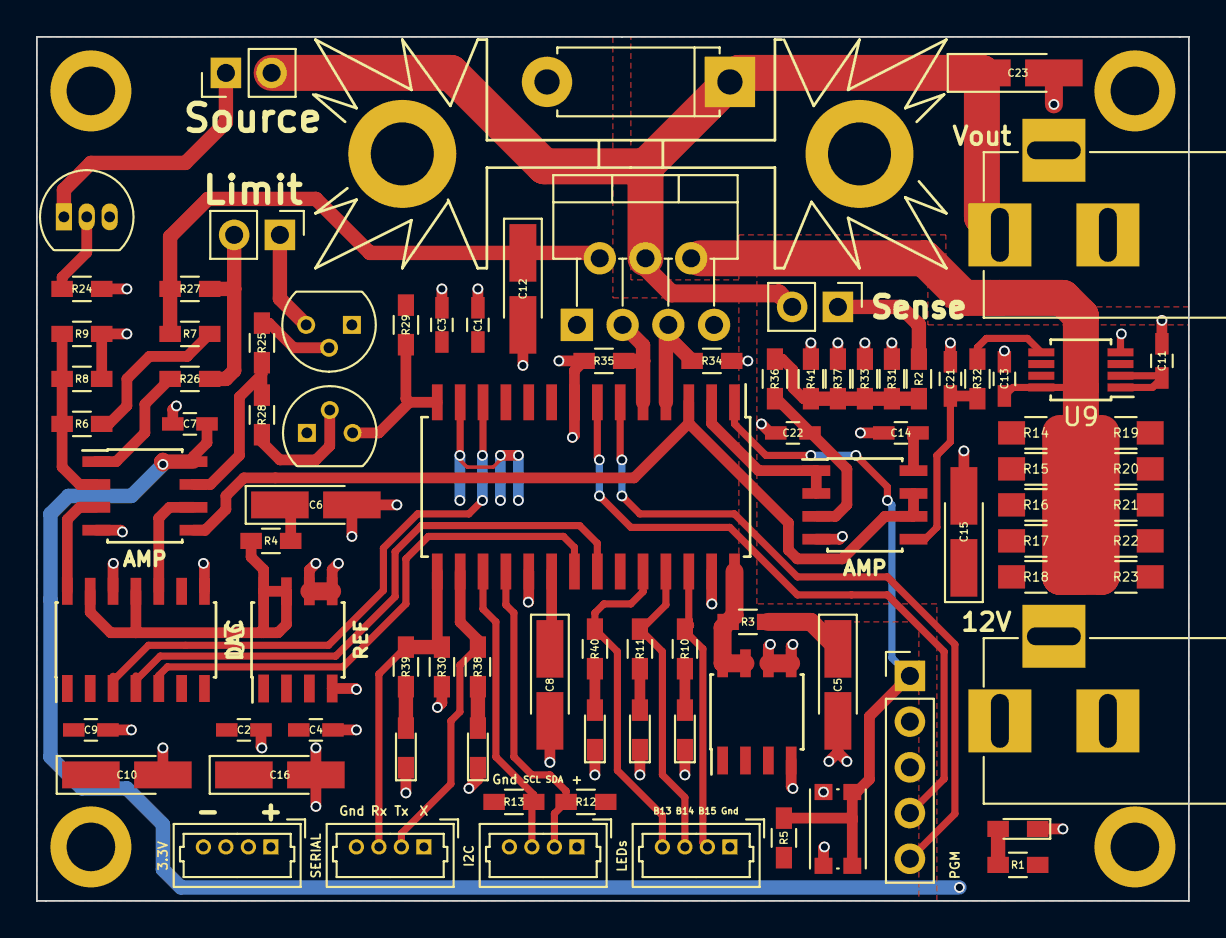
[picture p16: board PCB/V3/SupplyMainDigital.kicad_pcb from above]

Board: 2 copper layers, 64.0 x 48.0 mm, 94 parts (0 on the bottom side), 52 nets.
