WouterThys/PowerSupply/PCB/ConstantSupply/ConstantSupply.kicad_pcb

## KiCad design PCB/ConstantSupply/ConstantSupply.kicad_pcb (2018-03-10)

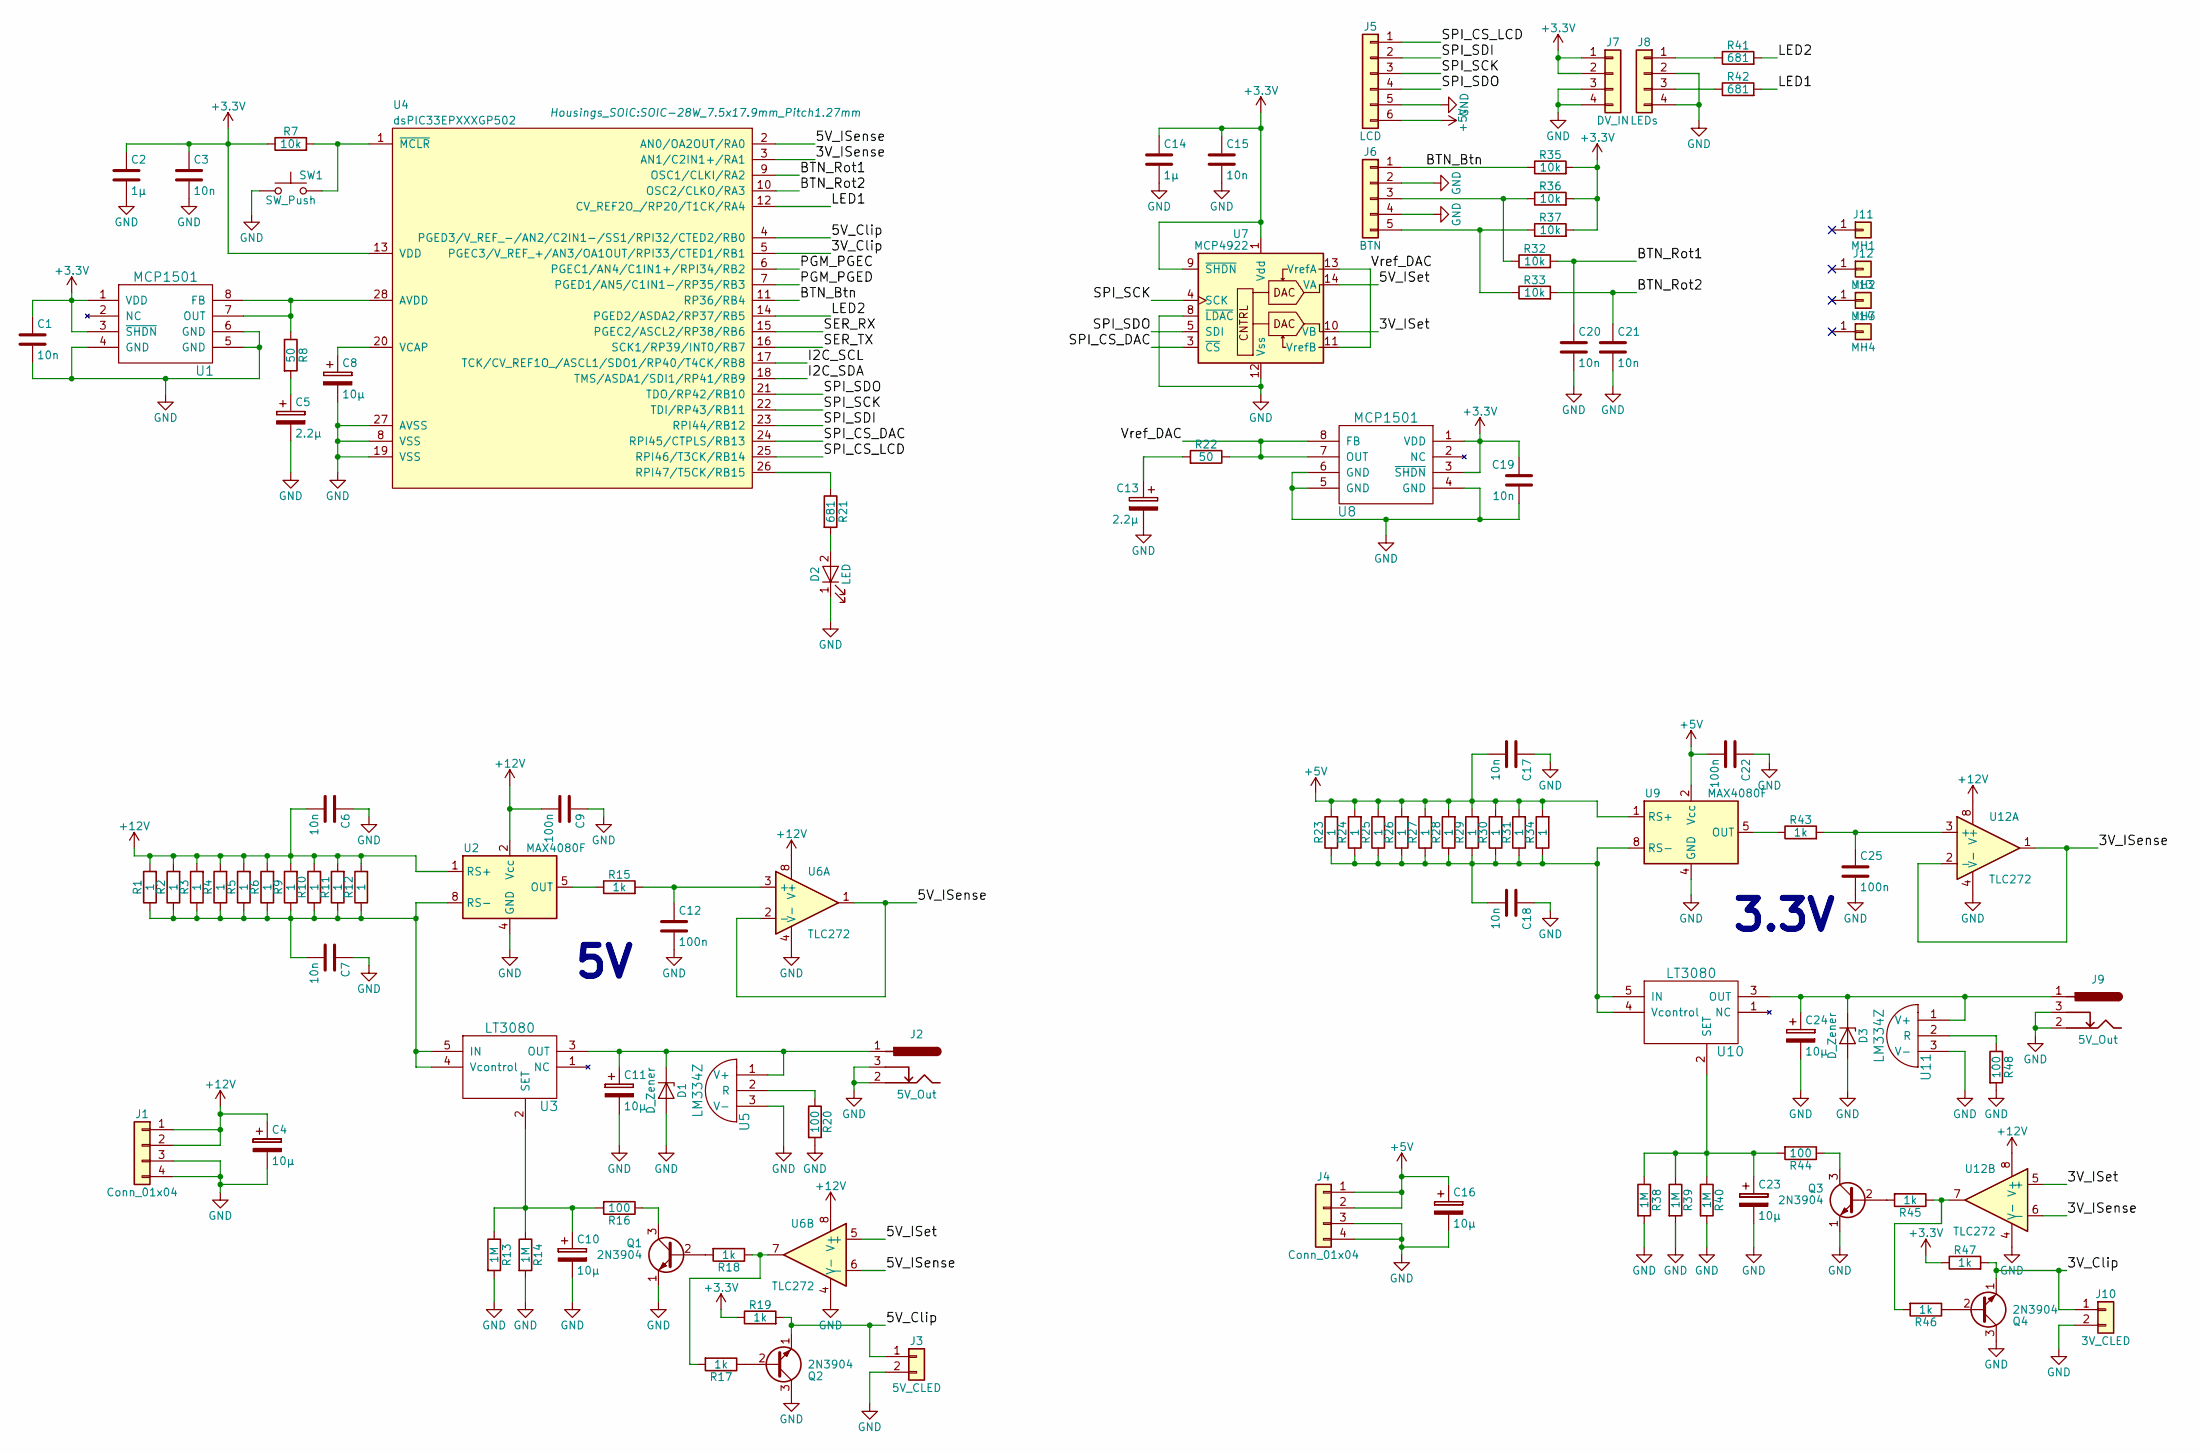
[picture p17: schematic ConstantSupply.sch]

Parts:
C1, C3, C6, C7, C15, C17, C18, C19, C20, C21: 10n; C_0603_HandSoldering
C2, C14: 1µ; C_0603_HandSoldering
C4, C8, C10, C11, C16, C23, C24: 10µ; CP_Tantalum_Case-A_EIA-3216-18_Reflow
C5, C13: 2.2µ; CP_Tantalum_Case-A_EIA-3216-18_Reflow
C9, C12, C22, C25: 100n; C_0603_HandSoldering
D1, D3: D_Zener; D_5W_P10.16mm_Horizontal
D2: LED; LED_0603_HandSoldering
J1, J4: Conn_01x04; Molex_PicoBlade_53047-0410_04x1.25mm_Straight
J2, J9: 5V_Out; BARREL_JACK
J3: 5V_CLED; Pin_Header_Straight_1x02_Pitch2.54mm
J5: LCD; Molex_PicoBlade_53047-0610_06x1.25mm_Straight
J6: BTN; Molex_PicoBlade_53047-0510_05x1.25mm_Straight
J7: DV_IN; Molex_PicoBlade_53047-0410_04x1.25mm_Straight
J8: LEDs; Molex_PicoBlade_53047-0410_04x1.25mm_Straight
J10: 3V_CLED; Pin_Header_Straight_1x02_Pitch2.54mm
J11: MH1; MountingHole_2.7mm_M2.5_ISO14580_Pad
J12: MH2; MountingHole_2.7mm_M2.5_ISO14580_Pad
J13: MH3; MountingHole_2.7mm_M2.5_ISO14580_Pad
J14: MH4; MountingHole_2.7mm_M2.5_ISO14580_Pad
Q1, Q2, Q3, Q4: 2N3904; TO-92_Inline_Narrow_Oval
R1, R2, R3, R4, R5, R6, R9, R10, R11, R12, R23, R24, R25, R26, R27, R28, R29, R30, R31, R34: 1; R_0805_HandSoldering
R7, R32, R33, R35, R36, R37: 10k; R_0603_HandSoldering
R8, R22: 50; R_0603_HandSoldering
R13, R14, R38, R39, R40: 1M; R_0805_HandSoldering
R15, R17, R18, R19, R43, R45, R46, R47: 1k; R_0603_HandSoldering
R16, R20, R44, R48: 100; R_0603_HandSoldering
R21, R41, R42: 681; R_0603_HandSoldering
SW1: SW_Push; SW_SPST_KMR2
U1, U8: MCP1501; SOIC-8_3.9x4.9mm_Pitch1.27mm
U2, U9: MAX4080F; MSOP-8_3x3mm_Pitch0.65mm
U3, U10: LT3080; TO-220-5_Pentawatt_Multiwatt-5_Vertical_StaggeredType1
U4: dsPIC33EPXXXGP502; SOIC-28W_7.5x17.9mm_Pitch1.27mm
U5, U11: LM334Z; TO-92_Inline_Narrow_Oval
U6, U12: TLC272; SOIC-8_3.9x4.9mm_Pitch1.27mm
U7: MCP4922; SOIC-14_3.9x8.7mm_Pitch1.27mm

Connections:
+3V3: C1.1, C2.1, C3.1, C14.1, C15.1, C19.1, J7.1, J7.2, R7.1, R19.1, R35.2, R36.2, R37.2, R47.1, U1.1 (VDD), U1.3 (~SHDN), U4.13 (VDD), U7.1 (Vdd), U7.9 (~SHDN), U8.1 (VDD), U8.3 (~SHDN)
+5V: C16.1, C17.2, C22.2, J4.1, J4.2, J5.6, R23.2, R24.2, R25.2, R26.2, R27.2, R28.2, R29.2, R30.2, R31.2, R34.2, U9.1 (RS+), U9.2 (Vcc)
+12V: C4.1, C6.2, C9.2, J1.1, J1.2, R1.2, R2.2, R3.2, R4.2, R5.2, R6.2, R9.2, R10.2, R11.2, R12.2, U2.1 (RS+), U2.2 (Vcc), U6.8 (V+), U12.8 (V+)
/3V_Clip: J10.1, Q4.1 (E), R47.2, U4.5 (PGEC3/V_REF_+/AN3/OA1OUT/RPI33/CTED1/RB1)
/3V_ISense: U4.3 (AN1/C2IN1+/RA1), U12.1, U12.2 (-), U12.6 (-)
/3V_ISet: U7.10 (VB), U12.5 (+)
/5V_Clip: J3.1, Q2.1 (E), R19.2, U4.4 (PGED3/V_REF_-/AN2/C2IN1-/SS1/RPI32/CTED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)
/5V_ISense: U4.2 (AN0/OA2OUT/RA0), U6.1, U6.2 (-), U6.6 (-)
/5V_ISet: U6.5 (+), U7.14 (VA)
/BTN_Btn: J6.1, R35.1, U4.11 (RP36/RB4)
/BTN_Rot1: C20.1, R32.2, U4.9 (OSC1/CLKI/RA2)
/BTN_Rot2: C21.1, R33.2, U4.10 (OSC2/CLKO/RA3)
/I2C_SCL: U4.17 (TCK/CV_REF1O_/ASCL1/SDO1/RP40/T4CK/RB8)
/I2C_SDA: U4.18 (TMS/ASDA1/SDI1/RP41/RB9)
/LED1: R42.2, U4.12 (CV_REF2O_/RP20/T1CK/RA4)
/LED2: R41.2, U4.14 (PGED2/ASDA2/RP37/RB5)
/PGM_PGEC: U4.6 (PGEC1/AN4/C1IN1+/RPI34/RB2)
/PGM_PGED: U4.7 (PGED1/AN5/C1IN1-/RP35/RB3)
/SER_RX: U4.15 (PGEC2/ASCL2/RP38/RB6)
/SER_TX: U4.16 (SCK1/RP39/INT0/RB7)
/SPI_CS_DAC: U4.24 (RPI45/CTPLS/RB13), U7.3 (~CS)
/SPI_CS_LCD: J5.1, U4.25 (RPI46/T3CK/RB14)
/SPI_SCK: J5.3, U4.22 (TDI/RP43/RB11), U7.4 (SCK)
/SPI_SDI: J5.2, U4.23 (RPI44/RB12)
/SPI_SDO: J5.4, U4.21 (TDO/RP42/RB10), U7.5 (SDI)
/Vref_DAC: R22.1, U7.11 (VrefB), U7.13 (VrefA), U8.7 (OUT), U8.8 (FB)
GND: C1.2, C2.2, C3.2, C4.2, C5.2, C6.1, C7.1, C8.2, C9.1, C10.2, C11.2, C12.2, C13.2, C14.2, C15.2, C16.2, C17.1, C18.1, C19.2, C20.2, C21.2, C22.1, C23.2, C24.2, C25.2, D1.2 (A), D2.1 (K), D3.2 (A), J1.3, J1.4, J2.2, J2.3, J3.2, J4.3, J4.4, J5.5, J6.2, J6.4, J7.3, J7.4, J8.2, J8.4, J9.2, J9.3, J10.2, Q1.1 (E), Q2.3 (C), Q3.1 (E), Q4.3 (C), R13.2, R14.2, R20.2, R38.2, R39.2, R40.2, R48.2, SW1.1, U1.4 (GND), U1.5 (GND), U1.6 (GND), U2.4 (GND), U4.8 (VSS), U4.19 (VSS), U4.27 (AVSS), U5.3 (V-), U6.4 (V-), U7.8 (~LDAC), U7.12 (Vss), U8.4 (GND), U8.5 (GND), U8.6 (GND), U9.4 (GND), U11.3 (V-), U12.4 (V-)
unnamed: C5.1, R8.2
unnamed: C7.2, R1.1, R2.1, R3.1, R4.1, R5.1, R6.1, R9.1, R10.1, R11.1, R12.1, U2.8 (RS-), U3.4 (Vcontrol), U3.5 (IN)
unnamed: C8.1, U4.20 (VCAP)
unnamed: C10.1, R13.1, R14.1, R16.2, U3.2 (SET)
unnamed: C11.1, D1.1 (K), J2.1, U3.3 (OUT), U5.1 (V+)
unnamed: C12.1, R15.2, U6.3 (+)
unnamed: C13.1, R22.2
unnamed: C18.2, R23.1, R24.1, R25.1, R26.1, R27.1, R28.1, R29.1, R30.1, R31.1, R34.1, U9.8 (RS-), U10.4 (Vcontrol), U10.5 (IN)
unnamed: C23.1, R38.1, R39.1, R40.1, R44.2, U10.2 (SET)
unnamed: C24.1, D3.1 (K), J9.1, U10.3 (OUT), U11.1 (V+)
unnamed: C25.1, R43.2, U12.3 (+)
unnamed: D2.2 (A), R21.2
unnamed: J6.3, R32.1, R36.1
unnamed: J6.5, R33.1, R37.1
unnamed: J8.1, R41.1
unnamed: J8.3, R42.1
unnamed: Q1.2 (B), R18.2
unnamed: Q1.3 (C), R16.1
unnamed: Q2.2 (B), R17.1
unnamed: Q3.2 (B), R45.2
unnamed: Q3.3 (C), R44.1
unnamed: Q4.2 (B), R46.1
unnamed: R7.2, SW1.2, U4.1 (~MCLR)
unnamed: R8.1, U1.7 (OUT), U1.8 (FB), U4.28 (AVDD)
unnamed: R15.1, U2.5 (OUT)
unnamed: R17.2, R18.1, U6.7
unnamed: R20.1, U5.2 (R)
unnamed: R21.1, U4.26 (RPI47/T5CK/RB15)
unnamed: R43.1, U9.5 (OUT)
unnamed: R45.1, R46.2, U12.7
unnamed: R48.1, U11.2 (R)

Notes on the sheet:
3.3V

Board: 2 copper layers, 107 parts (0 on the bottom side), 52 nets, no tracks yet.
