WouterThys/PowerSupply/PCB/ControlBoard/ControlBoard.kicad_pcb

## KiCad design PCB/ControlBoard/ControlBoard.kicad_pcb (2018-03-26)

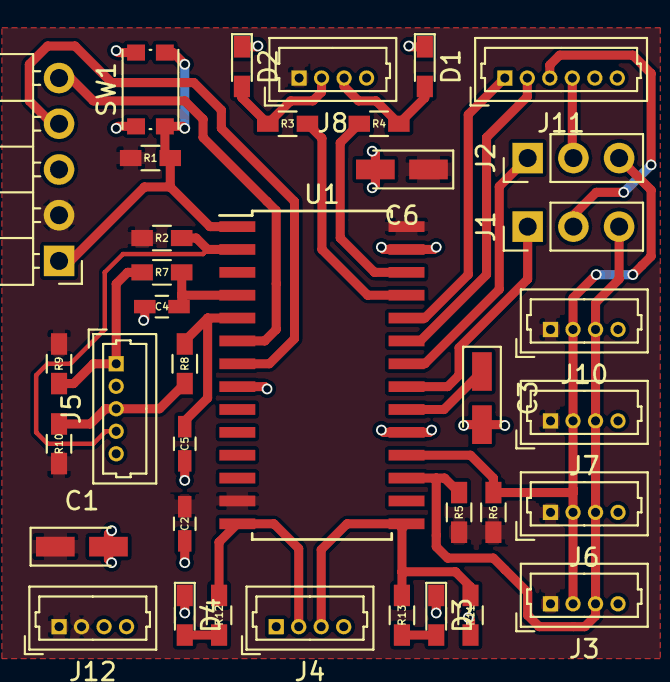
[picture p18: board ControlBoard.kicad_pcb from above]

Board: 2 copper layers, 37 parts (0 on the bottom side), 27 nets.

Parts:
C1, C3, C6: 1µ; CP_Tantalum_Case-A_EIA-3216-18_Wave
C2, C4, C5: 10n; C_0603_HandSoldering
D1, D2, D3, D4: LED; LED_0603_HandSoldering
J1, J2: Conn_01x03; Pin_Header_Straight_1x03_Pitch2.54mm
J3: I2C1; Molex_PicoBlade_53047-0410_04x1.25mm_Straight
J4: SERIAL; Molex_PicoBlade_53047-0410_04x1.25mm_Straight
J5: ENC; Molex_PicoBlade_53047-0510_05x1.25mm_Straight
J6: I2C2; Molex_PicoBlade_53047-0410_04x1.25mm_Straight
J7, J10: I2C3; Molex_PicoBlade_53047-0410_04x1.25mm_Straight
J8: LEDs; Molex_PicoBlade_53047-0410_04x1.25mm_Straight
J9: PGM; Pin_Header_Angled_1x05_Pitch2.54mm
J11: LCD; Molex_PicoBlade_53047-0610_06x1.25mm_Straight
J12: Pwr; Molex_PicoBlade_53047-0410_04x1.25mm_Straight
R1, R2, R9, R10, R11: 10k; R_0603_HandSoldering
R3, R4, R12, R13: 196; R_0603_HandSoldering
R5, R6: 2.2k; R_0603_HandSoldering
R7, R8: 1k; R_0603_HandSoldering
SW1: SW_Push; SW_SPST_KMR2
U1: dsPIC33EPXXXGP502; SOIC-28W_7.5x17.9mm_Pitch1.27mm

Connections:
+3V3: C1.1, C2.1, C6.1, J3.1, J6.1, J7.1, J8.1, J9.2, J10.1, J12.1, J12.2, R1.2, R2.2, R5.1, R6.1, R9.1, R10.1, U1.13, U1.28
/ENC_A: J5.1, R7.1, R9.2
/ENC_B: J5.3, R8.1, R10.2
/ENC_Btn: J5.4, R2.1, U1.2
/I2C_SCL: J1.3, J3.3, J6.3, J7.3, J10.3, R5.2, U1.17
/I2C_SDA: J2.3, J3.2, J6.2, J7.2, J10.2, R6.2, U1.18
/LED1: D2.2, J8.2, R3.1
/LED2: D1.2, J8.3, R4.1
/PGM_PGEC: J9.5, U1.6
/PGM_PGED: J9.4, U1.7
/RESET: J9.1, R1.1, SW1.2, U1.1
/SCK/SCL: J1.2, J11.3
/SDI/SDA: J2.2, J11.4
/SDO: J11.2, U1.23
/SER_RX: J4.3, R11.2, R13.2, U1.15
/SER_TX: J4.2, R12.2, U1.14
/SPISS: J11.1, U1.24
/SPI_SCK: J1.1, U1.21
/SPI_SDO: J2.1, U1.22
GND: C1.2, C2.2, C3.2, C4.1, C5.1, C6.2, D1.1, D2.1, D3.1, D4.1, J3.4, J4.4, J5.2, J5.5, J6.4, J7.4, J8.4, J9.3, J10.4, J11.5, J12.3, J12.4, R11.1, SW1.1, U1.8, U1.19, U1.27
unnamed: C3.1, U1.20
unnamed: C4.2, R7.2, U1.4
unnamed: C5.2, R8.2, U1.5
unnamed: D3.2, R13.1
unnamed: D4.2, R12.1
unnamed: R3.2, U1.25
unnamed: R4.2, U1.26
