WouterThys/PowerSupply/PCB/SimpleSupply/SimpleSupply.kicad_pcb

## KiCad design PCB/SimpleSupply/SimpleSupply.kicad_pcb (2018-02-01)

Schematic: SimpleSupply-2018-06-02-21-59-01.sch

Parts:
C2, C3, C6: 100n; C_0603_HandSoldering
C4, C7: 10µ; CP_Tantalum_Case-A_EIA-3216-18_Hand
C5, C8: 10n; C_0603_HandSoldering
D1, D2, D3: LED; LED_0603_HandSoldering
HS1, HS2: HEATSINK; Heatsink_Fischer_SK104-STCB_35x13mm__2xDrill3.5mm_ScrewM3
J1: Barrel_Jack; BARREL_JACK
J2: Vin_2; Pin_Header_Straight_1x02_Pitch2.54mm
J3: Vin_4; Pin_Header_Straight_1x04_Pitch1.27mm
J4: 5V_2; Pin_Header_Straight_1x02_Pitch2.54mm
J5: 5V_4; Pin_Header_Straight_1x04_Pitch1.27mm
J6: 3V3_2; Pin_Header_Straight_1x02_Pitch2.54mm
J7: 3V3_4; Pin_Header_Straight_1x04_Pitch1.27mm
R1: 1k; R_0603_HandSoldering
R2: 499k; R_0603_HandSoldering
R3: 390; R_0603_HandSoldering
R4: 330k; R_0603_HandSoldering
R5: 220; R_0603_HandSoldering
U1, U2: LT3080; TO-220-5_Pentawatt_Multiwatt-5_Vertical_StaggeredType1

Connections:
/3.3V: C7.1, C8.1, D3.2 (A), J6.1, J7.1, J7.2, U2.3
/5V: C4.1, C5.1, D2.2 (A), J4.1, J5.1, J5.2, U1.3, U2.4, U2.5
/Vin: C2.1, D1.2 (A), J1.1, J2.1, J3.1, J3.2, U1.4, U1.5
GND: C2.2, C3.2, C4.2, C5.2, C6.2, C7.2, C8.2, J1.2, J2.2, J3.3, J3.4, J4.2, J5.3, J5.4, J6.2, J7.3, J7.4, R1.2, R2.2, R3.2, R4.2, R5.2
unnamed: C3.1, R2.1, U1.2
unnamed: C6.1, R4.1, U2.2
unnamed: D1.1 (K), R1.1
unnamed: D2.1 (K), R3.1
unnamed: D3.1 (K), R5.1

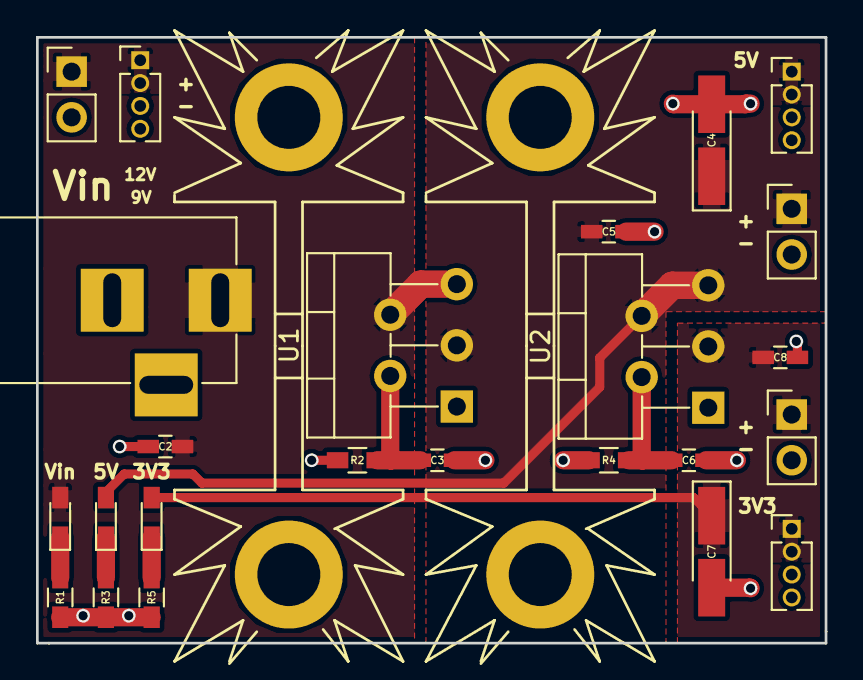
[picture p19: board SimpleSupply.kicad_pcb from above]

Board: 2 copper layers, 43.8 x 33.7 mm, 26 parts (0 on the bottom side), 9 nets.
