WouterThys/PowerSupply/PIC/VariableSupply.X/main.c

#include <xc.h>
#include <stdlib.h>
#include <stdio.h>
#include <stdint.h>        /* Includes uint16_t definition                    */
#include <stdbool.h>       /* Includes true/false definition                  */
#include <string.h>

#include "utils.h"
#include "Settings.h"
#include "../Common/CommonData.h"

#include "Drivers/SYSTEM_Driver.h"
#include "Drivers/UART_Driver.h"
#include "Drivers/I2C_Driver.h"
#include "Drivers/ADC_Driver.h"

#include "Controllers/DAC_Controller.h"
#include "Controllers/PID_Controller.h"


/*******************************************************************************
 *          DEFINES
 ******************************************************************************/
#define PID_TEST_CNT        128
#define TEST_VOLTAGE_STEP   200
#define TEST_BUFFER_CNT     50

/*******************************************************************************
 *          MACRO FUNCTIONS
 ******************************************************************************/

/*******************************************************************************
 *          DEFINES
 ******************************************************************************/


/*******************************************************************************
 *          VARIABLES
 ******************************************************************************/
static uint16_t dataArray[9];
static uint16_t * setVoltage;
static uint16_t * setCurrent;
static uint16_t * msrVoltage;
static uint16_t * msrCurrent;
static uint16_t * msrTemperature;
static uint16_t * msrCurrent_;
static uint16_t * calibrationState;
static uint16_t * calibrationCount;

static SupplyStatus_t status;
static i2cPackage_t i2cPackage;
static int16_t i2cError;

static int16_t i2cDone = -1;
static bool adcDone = false;

// Calibration
static Calibration_t calibrateArray[10];

/*******************************************************************************
 *          LOCAL FUNCTIONS
 ******************************************************************************/
static void initialize();
static void clipEnable(bool enable);
static void updateStatus(SupplyStatus_t status);

static void findLookupPoint(uint16_t * searchArray, uint16_t length, uint16_t value, uint16_t * x0, uint16_t * y0, uint16_t *x1, uint16_t *y1);
static float interpolate(uint16_t x0, uint16_t y0, uint16_t x1, uint16_t y1, uint16_t value);
static void printCalibration();

static void onI2cDone(i2cPackage_t data);
static void onAdcReadDone(uint16_t buffer, uint16_t * data);
static void onUartReadDone(UartData_t data);

void initialize() {
    sysInterruptEnable(false);
    
    // Initialize system
    sysInitPll();
    sysInitOscillator();
    sysInitPorts();
    
    // Interrupts
    sysInitInterrupts();
    sysInterruptEnable(true);
}

void clipEnable(bool enable) {
    if (enable) {
        CLIP_PIN_Dir = 1; // Input
        CLIP_PIN_Cn = 1; // Enable change notification

        _CNIF = 0; // Clear flag
        _CNIP = IP_CN; // Priority
        _CNIE = 1; // Enable interrupt
    } else {
        CLIP_PIN_Dir = 0; // Output
        CLIP_PIN_Cn = 0; // Disable change notification
        _CNIE = 0; // Disable interrupt
    }
}

void updateStatus(SupplyStatus_t status) {
    dataArray[I2C_COM_STATUS] = status.value;
}

void findLookupPoint(uint16_t * searchArray, uint16_t length, uint16_t value, uint16_t * x0, uint16_t *y0, uint16_t *x1, uint16_t *y1) {
    
    *x0 = *x1 = *y0 = *y1 = -1;
    
    if (value < searchArray[0]) {
        
        *x0 = 0;
        *x1 = 0;
        
        *y0 = searchArray[*x0];
        *y1 = searchArray[*x1];
        
        return;
    }
    
    if (value > searchArray[length-1]) {

        *x0 = length-1;
        *x1 = length-1;

        *y0 = searchArray[*x0];
        *y1 = searchArray[*x1];

        return;
    }
        
    uint16_t i;
    for (i = 0; i < length-1; i++) {

        if (value >= searchArray[i] && value < searchArray[i+1]) {

            *x0 = i;
            *x1 = i+1;

            *y0 = searchArray[*x0];
            *y1 = searchArray[*x1];

            break;
        }
    }
        
}

float interpolate(uint16_t x0, uint16_t y0, uint16_t x1, uint16_t y1, uint16_t x) {
    float t;

    if (x <= x0) { return y0; }
    if (x >= x1) { return y1; }

    t =  (x-x0);
    t /= (x1-x0);

    return y0 + t*(y1-y0);
}

void printCalibration() {
    uint16_t i;
    printf("Calibration:\n");
    printf(" Des\tCal\tCur\n");
    for (i = 0; i < 10; i++) {
        Calibration_t ct = calibrateArray[i];
        printf(" %d\t%d\t%d\n", ct.desiredVoltage, ct.calibratedVoltage, ct.measuredCurrent);
    }
}


/*******************************************************************************
 *          MAIN PROGRAM
 ******************************************************************************/

int main(void) {
    initialize();
    
    // Variables
    setVoltage = &dataArray[I2C_COM_SET_V];
    setCurrent = &dataArray[I2C_COM_SET_I];
    msrVoltage = &dataArray[I2C_COM_MSR_V];
    msrCurrent = &dataArray[I2C_COM_MSR_I];
    msrTemperature = &dataArray[I2C_COM_MSR_T];
    msrCurrent_ = &dataArray[I2C_COM_MSR_I_];
    calibrationState = &dataArray[I2C_COM_CAL_STATE];
    calibrationCount = &dataArray[I2C_COM_CAL_COUNT];
    
    *setVoltage = 0x0000;
    *setCurrent = 0x0FFF; // Max
    *msrVoltage = 0x0000;
    *msrCurrent = 0x0000;
    *msrTemperature = 0x0000;
    *msrCurrent_ = 0x0000;
    
    status.statusCode = STAT_VOID;
    status.currentClip = 0;
    status.errorCode = 0;
    status.outputEnabled = 0; 
    updateStatus(status);
    
    // Initial values
    i2cPackage.address = I2C_ADDRESS;
    i2cPackage.data = dataArray;
    i2cPackage.length = 7;
    i2cError = I2C_OK;
    
    // Initialize
    dacInit();
    uartDriverInit(UART1_BAUD, &onUartReadDone);
    i2cDriverInit(&i2cPackage , &onI2cDone);
    adcDriverInit(&onAdcReadDone);
    OUTPUT_ON_Dir = 1; // Input to check if output is enabled
    
    dacEnable(true);
    uartDriverEnable(DEBUG);
    i2cDriverEnable(true);
    DelayMs(100);
    
    // Default
    dacSetValueA(*setVoltage);
    dacSetValueB(*setCurrent);
    
    DelayMs(10);
    if (DEBUG) printf("start\n");
    
    // Enable
    adcDriverEnable(true);
    clipEnable(true);
    
    // Set status running
    status.statusCode = STAT_RUNNING;
    updateStatus(status);
    
    while(1) {
       
        if (i2cDone >= 0) {
            
            if (DEBUG_I2C) printf("I2C: %d\n", i2cDone);
            
            switch(i2cDone) {
                case I2C_COM_SET_V:
                    dacSetValueA(*setVoltage);
                    break;
                case I2C_COM_SET_I:
                    dacSetValueB(*setCurrent);
                    break;
                case I2C_COM_CAL_STATE:
                    status.calibrationSt = *calibrationState; // For ACK
                    status.statusCode = STAT_CALIBRATING;
                    updateStatus(status);
                    if (DEBUG_FSM) printf("FSM: %d, %d\n", *calibrationState, *calibrationCount);
                    switch(*calibrationState) {
                        case C_INIT:
                            break;
                        case C_SET_DESIRED:
                            break;
                        case C_SAVE:
                            calibrateArray[(*calibrationCount)-1].desiredVoltage = CALIB_MIN + (((*calibrationCount)-1) * CALIB_STEP);
                            calibrateArray[(*calibrationCount)-1].calibratedVoltage = *setVoltage;
                            calibrateArray[(*calibrationCount)-1].measuredCurrent = *msrCurrent;
                            break;
                        case C_DONE:
                            
                            // TODO: save to flash
                            
                            if (DEBUG_FSM) printCalibration();
                            status.calibrationSt = 0; 
                            status.statusCode = STAT_RUNNING;
                            break;
                    }
                    break;
                default:
                    break;
            }
            
            i2cDone = -1;
        }
        
        if (adcDone) {
            adcDone = false;
            // TODO: PID
            if (status.pidEnabled) {
                //..
            }
            
            // TODO: do this with interrupt or timer
            status.outputEnabled = OUTPUT_ON_Pin;
            LED1 = !LED1;
        }
    }
}

//  Clip interrupt
void __attribute__ ( (interrupt, no_auto_psv) ) _CNInterrupt(void) {
    if (_CNIF) {
        bool clip = !CLIP_PIN;
        status.currentClip = clip;
        updateStatus(status);
        CLIP_LED = clip;
        _CNIF = 0; // Clear interrupt
    }
}

void onI2cDone(i2cPackage_t data) {
    // We are only interested when master writes
    if (data.status == I2C_MWRITE) { 
        i2cDone = data.command; 
    }
}

void onAdcReadDone(uint16_t buffer, uint16_t * data) {
    if (status.calibrateEnabled) {
        //..
    } else {
        dataArray[I2C_COM_MSR_V + buffer] = (uint16_t) average(data, ADC_BUFFER_SIZE);
    }
    adcDone = true;
}


void onUartReadDone(UartData_t data) {
    
}
