WouterThys/PowerSupply/PIC/PowerSupply.X/Drivers/INTERRUPT_Driver.c

#include <xc.h>
#include <stdio.h>
#include <stdint.h>        /* Includes uint16_t definition                    */
#include <stdbool.h>       /* Includes true/false definition                  */

#include "../Settings.h"
#include "../Controllers/UART_Controller.h"
#include "SYSTEM_Driver.h"
#include "UART_Driver.h"
#include "ADC_Driver.h"
#include "INTERRUPT_Driver.h"


/*******************************************************************************
 *          DEFINES
 ******************************************************************************/

/*******************************************************************************
 *          MACRO FUNCTIONS
 ******************************************************************************/

/*******************************************************************************
 *          VARIABLES
 ******************************************************************************/

/*******************************************************************************
 *          DRIVER FUNCTIONS
 ******************************************************************************/
void D_INT_Init(void) {
    INTCON1 = 0x0000;       // Clear all special pending flags
    INTCON3 = 0x0000;
    INTCON4 = 0x0000;

    _NSTDIS = 0; // Enable Interrupt Nesting   MUST !!!!
    return;
}

void D_INT_EnableInterrupts(bool enable) {
    if(enable) {
        _IPL = 0b000; // Set CPU at Level = 0
        _IPL3 = 0; // Lower priority
        _GIE = 1; // Global interrupt enable
    } else {    
        _IPL = 0b111; // Set CPU at Level = 7  (DISABLE ALL INTERRUPTS)
        _GIE = 0; // Global interrupt disable
    }
}

void D_INT_EnableUartInterrupts(bool enable) {
    if (enable) {
        _U1RXIF = 0; // Clear flag
        _U1RXIP = U1RX_IP; // Priority
        _U1RXIE = 1; // Enable interrupts
    } else {
        _U1RXIE = 0; // Disable interrupts
    }
}

void D_INT_EnableADCInterrupts(bool enable) {
    if (enable) {
        _AD1IF = 0; // Clear flag
        _AD1IP = ADC1_IP; // Priority
        _AD1IE = 1; // Enable interrupts
    } else {
        _AD1IE = 0; // Disable interrupts
    }
}

void D_INT_EnableSPIInterrupts(bool enable) {
    if (enable) {
        _SPI2IF = 0; // Clear flag
        _SPI2IP = SPI2_IP; // Priority
        _SPI2IE = 1;
    } else {
        _SPI2IE = 0; // Disable interrupts
    }
}

/*******************************************************************************
 *          INTERRUPTS
 ******************************************************************************/

// UART Received byte
void __attribute__ ( (interrupt, no_auto_psv) ) _U1RXInterrupt(void) {
    if (_U1RXIF) {
        C_UART_NewData(D_UART_ReadByte());
        _U1RXIF = 0; // Clear interrupt
    }
}

//  ADC conversion done
void __attribute__ ( (interrupt, no_auto_psv) ) _AD1Interrupt(void) {
    if (_AD1IF) {
        _AD1IF = 0;
        ADC_Values[0] = ADC1BUF0;
        ADC_Values[1] = ADC1BUF1;
        ADC_Values[2] = ADC1BUF2;
        ADC_Values[3] = ADC1BUF3;
        ADC_flag = 1;
    }
}

// SPI TX done
void __attribute__ ( (interrupt, no_auto_psv) ) _SPI2Interrupt(void) {
    if (_SPI2IF) {
        SPI2_FS_Pin = 1;
        uint16_t dummy = SPI2BUF;
        _SPI2IF = 0;
    }
}



/******************************************************************************/
/* Interrupt Vector Options                                                   */
/******************************************************************************/
/*                                                                            */
/* Refer to the C30 (MPLAB C Compiler for PIC24F MCUs and dsPIC33F DSCs) User */
/* Guide for an up to date list of the available interrupt options.           */
/* Alternately these names can be pulled from the device linker scripts.      */
/*                                                                            */
/* dsPIC33F Primary Interrupt Vector Names:                                   */
/*                                                                            */
/* _INT0Interrupt      _C1Interrupt                                           */
/* _IC1Interrupt       _DMA3Interrupt                                         */
/* _OC1Interrupt       _IC3Interrupt                                          */
/* _T1Interrupt        _IC4Interrupt                                          */
/* _DMA0Interrupt      _IC5Interrupt                                          */
/* _IC2Interrupt       _IC6Interrupt                                          */
/* _OC2Interrupt       _OC5Interrupt                                          */
/* _T2Interrupt        _OC6Interrupt                                          */
/* _T3Interrupt        _OC7Interrupt                                          */
/* _SPI1ErrInterrupt   _OC8Interrupt                                          */
/* _SPI1Interrupt      _DMA4Interrupt                                         */
/* _U1RXInterrupt      _T6Interrupt                                           */
/* _U1TXInterrupt      _T7Interrupt                                           */
/* _ADC1Interrupt      _SI2C2Interrupt                                        */
/* _DMA1Interrupt      _MI2C2Interrupt                                        */
/* _SI2C1Interrupt     _T8Interrupt                                           */
/* _MI2C1Interrupt     _T9Interrupt                                           */
/* _CNInterrupt        _INT3Interrupt                                         */
/* _INT1Interrupt      _INT4Interrupt                                         */
/* _ADC2Interrupt      _C2RxRdyInterrupt                                      */
/* _DMA2Interrupt      _C2Interrupt                                           */
/* _OC3Interrupt       _DCIErrInterrupt                                       */
/* _OC4Interrupt       _DCIInterrupt                                          */
/* _T4Interrupt        _DMA5Interrupt                                         */
/* _T5Interrupt        _U1ErrInterrupt                                        */
/* _INT2Interrupt      _U2ErrInterrupt                                        */
/* _U2RXInterrupt      _DMA6Interrupt                                         */
/* _U2TXInterrupt      _DMA7Interrupt                                         */
/* _SPI2ErrInterrupt   _C1TxReqInterrupt                                      */
/* _SPI2Interrupt      _C2TxReqInterrupt                                      */
/* _C1RxRdyInterrupt                                                          */
/*                                                                            */
/* dsPIC33E Primary Interrupt Vector Names:                                   */
/*                                                                            */
/* _INT0Interrupt     _IC4Interrupt      _U4TXInterrupt                       */
/* _IC1Interrupt      _IC5Interrupt      _SPI3ErrInterrupt                    */
/* _OC1Interrupt      _IC6Interrupt      _SPI3Interrupt                       */
/* _T1Interrupt       _OC5Interrupt      _OC9Interrupt                        */
/* _DMA0Interrupt     _OC6Interrupt      _IC9Interrupt                        */
/* _IC2Interrupt      _OC7Interrupt      _PWM1Interrupt                       */
/* _OC2Interrupt      _OC8Interrupt      _PWM2Interrupt                       */
/* _T2Interrupt       _PMPInterrupt      _PWM3Interrupt                       */
/* _T3Interrupt       _DMA4Interrupt     _PWM4Interrupt                       */
/* _SPI1ErrInterrupt  _T6Interrupt       _PWM5Interrupt                       */
/* _SPI1Interrupt     _T7Interrupt       _PWM6Interrupt                       */
/* _U1RXInterrupt     _SI2C2Interrupt    _PWM7Interrupt                       */
/* _U1TXInterrupt     _MI2C2Interrupt    _DMA8Interrupt                       */
/* _AD1Interrupt      _T8Interrupt       _DMA9Interrupt                       */
/* _DMA1Interrupt     _T9Interrupt       _DMA10Interrupt                      */
/* _NVMInterrupt      _INT3Interrupt     _DMA11Interrupt                      */
/* _SI2C1Interrupt    _INT4Interrupt     _SPI4ErrInterrupt                    */
/* _MI2C1Interrupt    _C2RxRdyInterrupt  _SPI4Interrupt                       */
/* _CM1Interrupt      _C2Interrupt       _OC10Interrupt                       */
/* _CNInterrupt       _QEI1Interrupt     _IC10Interrupt                       */
/* _INT1Interrupt     _DCIEInterrupt     _OC11Interrupt                       */
/* _AD2Interrupt      _DCIInterrupt      _IC11Interrupt                       */
/* _IC7Interrupt      _DMA5Interrupt     _OC12Interrupt                       */
/* _IC8Interrupt      _RTCCInterrupt     _IC12Interrupt                       */
/* _DMA2Interrupt     _U1ErrInterrupt    _DMA12Interrupt                      */
/* _OC3Interrupt      _U2ErrInterrupt    _DMA13Interrupt                      */
/* _OC4Interrupt      _CRCInterrupt      _DMA14Interrupt                      */
/* _T4Interrupt       _DMA6Interrupt     _OC13Interrupt                       */
/* _T5Interrupt       _DMA7Interrupt     _IC13Interrupt                       */
/* _INT2Interrupt     _C1TxReqInterrupt  _OC14Interrupt                       */
/* _U2RXInterrupt     _C2TxReqInterrupt  _IC14Interrupt                       */
/* _U2TXInterrupt     _QEI2Interrupt     _OC15Interrupt                       */
/* _SPI2ErrInterrupt  _U3ErrInterrupt    _IC15Interrupt                       */
/* _SPI2Interrupt     _U3RXInterrupt     _OC16Interrupt                       */
/* _C1RxRdyInterrupt  _U3TXInterrupt     _IC16Interrupt                       */
/* _C1Interrupt       _USB1Interrupt     _ICDInterrupt                        */
/* _DMA3Interrupt     _U4ErrInterrupt    _PWMSpEventMatchInterrupt            */
/* _IC3Interrupt      _U4RXInterrupt     _PWMSecSpEventMatchInterrupt         */
/*                                                                            */
/* For alternate interrupt vector naming, simply add 'Alt' between the prim.  */
/* interrupt vector name '_' and the first character of the primary interrupt */
/* vector name.  There is no Alternate Vector or 'AIVT' for the 33E family.   */
/*                                                                            */
/* For example, the vector name _ADC2Interrupt becomes _AltADC2Interrupt in   */
/* the alternate vector table.                                                */
/*                                                                            */
/* Example Syntax:                                                            */
/*                                                                            */
/* void __attribute__((interrupt,auto_psv)) <Vector Name>(void)               */
/* {                                                                          */
/*     <Clear Interrupt Flag>                                                 */
/* }                                                                          */
/*                                                                            */
/* For more comprehensive interrupt examples refer to the C30 (MPLAB C        */
/* Compiler for PIC24 MCUs and dsPIC DSCs) User Guide in the                  */
/* <C30 compiler instal directory>/doc directory for the latest compiler      */
/* release.  For XC16, refer to the MPLAB XC16 C Compiler User's Guide in the */
/* <XC16 compiler instal directory>/doc folder.                               */
/*                                                                            */
/******************************************************************************/
