WouterThys/PowerSupply/PIC/VariableSupply.X/Drivers/ADC_Driver.h

#ifndef ADC_DRIVER_H
#define	ADC_DRIVER_H

#include "../Settings.h"

/******************************************************************************/
/* System Function Prototypes                                                 */
/******************************************************************************/

void adcDriverInit(void (*onAdcReadDone)(uint16_t buffer, uint16_t * data));
void adcDriverEnable(bool enable);


#endif
