WouterThys/PowerSupply/PIC/MainGLCDController.X/Drivers/GLCD_bitmaps.h

#ifndef _GLCD_BITMAPS_H_
#define	_GLCD_BITMAPS_H_

/*
 *
 * System5x7
 *
 *
 * File Name           : System5x7.h
 * Date                : 28 Oct 2008
 * Font size in bytes  : 470
 * Font width          : 5
 * Font height         : 7
 * Font first char     : 32
 * Font last char      : 127
 * Font used chars     : 94
 *
 * The font data are defined as
 *
 * struct _FONT_ {
 *     uint16_t   font_Size_in_Bytes_over_all_included_Size_it_self;
 *     uint8_t    font_Width_in_Pixel_for_fixed_drawing;
 *     uint8_t    font_Height_in_Pixel_for_all_characters;
 *     unit8_t    font_First_Char;
 *     uint8_t    font_Char_Count;
 *
 *     uint8_t    font_Char_Widths[font_Last_Char - font_First_Char +1];
 *                  // for each character the separate width in pixels,
 *                  // characters < 128 have an implicit virtual right empty row
 *
 *     uint8_t    font_data[];
 *                  // bit field of all characters
 */

#include <stdint.h>

#define SYSTEM5x7_WIDTH 5
#define SYSTEM5x7_HEIGHT 7

static const uint8_t font[] = {
    0x0, 0x0, // size of zero indicates fixed width font, actual length is width * height
    0x05, // width
    0x07, // height
    0x20, // first char
    0x7f, // char count

    // Fixed width; char width table not used !!!!

    // font data
    0x00, 0x00, 0x00, 0x00, 0x00,// (space)
	0x00, 0x00, 0x5F, 0x00, 0x00,// !
	0x00, 0x07, 0x00, 0x07, 0x00,// "
	0x14, 0x7F, 0x14, 0x7F, 0x14,// #
	0x24, 0x2A, 0x7F, 0x2A, 0x12,// $
	0x23, 0x13, 0x08, 0x64, 0x62,// %
	0x36, 0x49, 0x55, 0x22, 0x50,// &
	0x00, 0x05, 0x03, 0x00, 0x00,// '
	0x00, 0x1C, 0x22, 0x41, 0x00,// (
	0x00, 0x41, 0x22, 0x1C, 0x00,// )
	0x08, 0x2A, 0x1C, 0x2A, 0x08,// *
	0x08, 0x08, 0x3E, 0x08, 0x08,// +
	0x00, 0x50, 0x30, 0x00, 0x00,// ,
	0x08, 0x08, 0x08, 0x08, 0x08,// -
	0x00, 0x60, 0x60, 0x00, 0x00,// .
	0x20, 0x10, 0x08, 0x04, 0x02,// /
	0x3E, 0x51, 0x49, 0x45, 0x3E,// 0
	0x00, 0x42, 0x7F, 0x40, 0x00,// 1
	0x42, 0x61, 0x51, 0x49, 0x46,// 2
	0x21, 0x41, 0x45, 0x4B, 0x31,// 3
	0x18, 0x14, 0x12, 0x7F, 0x10,// 4
	0x27, 0x45, 0x45, 0x45, 0x39,// 5
	0x3C, 0x4A, 0x49, 0x49, 0x30,// 6
	0x01, 0x71, 0x09, 0x05, 0x03,// 7
	0x36, 0x49, 0x49, 0x49, 0x36,// 8
	0x06, 0x49, 0x49, 0x29, 0x1E,// 9
	0x00, 0x36, 0x36, 0x00, 0x00,// :
	0x00, 0x56, 0x36, 0x00, 0x00,// ;
	0x00, 0x08, 0x14, 0x22, 0x41,// <
	0x14, 0x14, 0x14, 0x14, 0x14,// =
	0x41, 0x22, 0x14, 0x08, 0x00,// >
	0x02, 0x01, 0x51, 0x09, 0x06,// ?
	0x32, 0x49, 0x79, 0x41, 0x3E,// @
	0x7E, 0x11, 0x11, 0x11, 0x7E,// A
	0x7F, 0x49, 0x49, 0x49, 0x36,// B
	0x3E, 0x41, 0x41, 0x41, 0x22,// C
	0x7F, 0x41, 0x41, 0x22, 0x1C,// D
	0x7F, 0x49, 0x49, 0x49, 0x41,// E
	0x7F, 0x09, 0x09, 0x01, 0x01,// F
	0x3E, 0x41, 0x41, 0x51, 0x32,// G
	0x7F, 0x08, 0x08, 0x08, 0x7F,// H
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

};

//0x45, 0x00, 0x40, 0x00,
static const unsigned char panda_bmp [] = {
0x45, 0x40, 
0xC0, 0xF0, 0xF8, 0xFC, 0xFE, 0xFE, 0xFF, 0xFF, 0xFF, 0xFF, 0xFF, 0xFF, 0xFF, 0xFF, 0xFF, 0xFF,
0xFF, 0xFF, 0xFF, 0xFF, 0x03, 0x01, 0x39, 0x01, 0x03, 0x03, 0x03, 0x03, 0x03, 0x03, 0x03, 0x03,
0x33, 0x71, 0x39, 0x39, 0x01, 0x03, 0x7F, 0xFF, 0xFF, 0xFF, 0xFF, 0xFF, 0xFF, 0xFF, 0xFF, 0xFF,
0xFF, 0xFF, 0xFF, 0xFF, 0xFF, 0xFF, 0xFF, 0xFF, 0xFF, 0xFF, 0xFF, 0xFF, 0xFF, 0xFF, 0xFF, 0xFF,
0xFF, 0xFF, 0xFF, 0xFF, 0xFF, 0xFF, 0xFF, 0xFF, 0xFF, 0xFF, 0x3F, 0x1F, 0x1F, 0x0F, 0x0F, 0x0F,
0x0F, 0x0F, 0x1F, 0x1F, 0x3F, 0xFF, 0xFF, 0x07, 0x01, 0x00, 0x00, 0x80, 0x00, 0x00, 0x00, 0x00,
0x00, 0xC0, 0xC0, 0x00, 0x00, 0x00, 0x00, 0x00, 0x00, 0x80, 0x80, 0x00, 0x01, 0x07, 0x1F, 0x3F,
0x7F, 0x7F, 0xFF, 0x7F, 0x7F, 0x3F, 0x1F, 0x03, 0x81, 0x80, 0x80, 0xE0, 0xE0, 0x80, 0x80, 0x81,
0x03, 0x0F, 0xFF, 0xFF, 0xFF, 0xFF, 0xFF, 0xFF, 0xFF, 0xFF, 0xFF, 0xFF, 0xFF, 0xFF, 0xFF, 0xE0,
0x80, 0x00, 0x38, 0x7E, 0xFE, 0xF8, 0xF8, 0xFC, 0xFC, 0xF8, 0xF1, 0xF1, 0xF0, 0xF8, 0xF0, 0xE0,
0x80, 0x00, 0x00, 0x00, 0x00, 0x00, 0x81, 0x81, 0x80, 0xC0, 0xE0, 0xF0, 0xF0, 0xFC, 0xFF, 0xFF,
0xFF, 0xFE, 0xFE, 0xFF, 0xFE, 0xFE, 0xFE, 0xFE, 0xFE, 0xFE, 0xFE, 0xFE, 0xFF, 0xFF, 0xFF, 0x7F,
0x7F, 0x3F, 0x1F, 0x07, 0x80, 0xF0, 0xFC, 0xFF, 0xFF, 0xFF, 0xFF, 0xFF, 0xFF, 0xFF, 0xFF, 0xFF,
0xFF, 0xFF, 0xFF, 0xFF, 0xFF, 0xFF, 0xFF, 0xFC, 0xFC, 0xF8, 0xE1, 0xE3, 0xC3, 0xC7, 0x8F, 0x8F,
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
0xF0, 0x00, 0x00, 0x00, 0x00, 0x01, 0x00, 0x02, 0x00, 0x04, 0x02, 0x00, 0x00, 0x00, 0x00, 0x00,
0x02, 0x00, 0x11, 0x02, 0x00, 0x09, 0x00, 0x80, 0x01, 0x00, 0x08, 0x01, 0xA0, 0xFC, 0xFE, 0xFE,
0xFC, 0xFC, 0xF8, 0xF8, 0xF0, 0x00, 0x00, 0x00, 0x00, 0x00, 0x00, 0x00, 0x00, 0x00, 0x00, 0x00,
0x00, 0x20, 0x00, 0x54, 0x02, 0x04, 0x80, 0x00, 0x00, 0x00, 0xC0, 0xF8, 0xFF, 0xFF, 0xFF, 0xFF,
0xFF, 0xFF, 0xFF, 0xFF, 0xFF, 0xFF, 0xFF, 0xF8, 0xC0, 0x80, 0x00, 0x00, 0x00, 0x00, 0x00, 0x00,
0x00, 0x00, 0x00, 0x00, 0x00, 0x00, 0x00, 0x00, 0x00, 0x00, 0x00, 0x00, 0x00, 0x00, 0xC0, 0xF8,
0xFE, 0xFF, 0xFF, 0xFF, 0xFF, 0xFF, 0xFF, 0xFF, 0xFF, 0xFF, 0xFF, 0xA0, 0x00, 0x40, 0x08, 0x20,
0xA2, 0x04, 0x00, 0x00, 0x00, 0xA5, 0x00, 0x48, 0x11, 0x04, 0x00, 0x80, 0x14, 0x80, 0xE9, 0xFF,
0xFF, 0xFF, 0xFF, 0xFF, 0xFF, 0xFF, 0xFF, 0xFF, 0xFF, 0xFF, 0xFF, 0xFF, 0xFF, 0xFF, 0xFF, 0xFE,
0xE0, 0x80, 0x00, 0x00, 0x20, 0x00, 0x00, 0x00, 0x00, 0x00, 0x00, 0x00, 0x00, 0x80, 0x80, 0xC0,
0xE0, 0xF8, 0xFF, 0xFF, 0xFF, 0xFF, 0xFF, 0xFF, 0xFF, 0xFF, 0xFF, 0xFF, 0xFF, 0xFF, 0xFF, 0xFF,
0xFF, 0xBC, 0x41, 0x18, 0xC2, 0x15, 0x01, 0x00,
};

#endif	/* _GLCD_BITMAPS_H_ */
