WouterThys/PowerSupply/PIC/MainController.X/configuration.c

/******************************************************************************/
/* Files to Include                                                           */
/******************************************************************************/

/* Device header file */
#if defined(__XC16__)
    #include <xc.h>
#elif defined(__C30__)
    #if defined(__dsPIC33E__)
    	#include <p33Exxxx.h>
    #elif defined(__dsPIC33F__)
    	#include <p33Fxxxx.h>
    #endif
#endif

/******************************************************************************/
/* Configuration Bits                                                         */
/*                                                                            */
/* This is not all available configuration bits for all dsPIC devices.        */
/* Refer to the dsPIC device specific .h file in the compiler                 */
/* support\dsPIC33F\h directory for complete options specific to the device   */
/* selected.  For additional information about what hardware configurations   */
/* mean in terms of device operation, refer to the device datasheet           */
/* 'Special Features' chapter.                                                */
/*                                                                            */
/* A feature of MPLAB X is the 'Generate Source Code to Output' utility in    */
/* the Configuration Bits window.  Under Window > PIC Memory Views >          */
/* Configuration Bits, a user controllable configuration bits window is       */
/* available to Generate Configuration Bits source code which the user can    */
/* paste into this project.                                                   */
/******************************************************************************/

/// FICD
#pragma config ICS = PGD1               // ICD Communication Channel Select bits (Communicate on PGEC1 and PGED1)
#pragma config JTAGEN = OFF             // JTAG Enable bit (JTAG is disabled)

// FPOR
#pragma config ALTI2C1 = OFF             // Alternate I2C1 pins (I2C1 mapped to SDA1/SCL1 pins)
#pragma config ALTI2C2 = ON            // Alternate I2C2 pins (I2C2 mapped to SDA2/SCL2 pins)
#pragma config WDTWIN = WIN25           // Watchdog Window Select bits (WDT Window is 25% of WDT period)

// FWDT
#pragma config WDTPOST = PS32768        // Watchdog Timer Postscaler bits (1:32,768)
#pragma config WDTPRE = PR128           // Watchdog Timer Prescaler bit (1:128)
#pragma config PLLKEN = OFF              // PLL Lock Enable bit (Clock switch to PLL source will wait until the PLL lock signal is valid.)
#pragma config WINDIS = OFF             // Watchdog Timer Window Enable bit (Watchdog Timer in Non-Window mode)
#pragma config FWDTEN = OFF             // Watchdog Timer Enable bit (Watchdog timer enabled/disabled by user software)

// FOSC
#pragma config POSCMD = NONE            // Primary Oscillator Mode Select bits (Primary Oscillator disabled)
#pragma config OSCIOFNC = OFF            // OSC2 Pin Function bit (OSC2 is general purpose digital I/O pin)
#pragma config IOL1WAY = ON             // Peripheral pin select configuration (Allow only one reconfiguration)
#pragma config FCKSM = CSECMD           // Clock Switching Mode bits (Clock switching is enabled,Fail-safe Clock Monitor is disabled)

// FOSCSEL
#pragma config FNOSC = FRCPLL           // Oscillator Source Selection (Fast RC Oscillator with divide-by-N with PLL module
#pragma config IESO = ON                // Two-speed Oscillator Start-up Enable bit (Start up device with FRC, then switch to user-selected oscillator source)

// FGS
#pragma config GWRP = OFF               // General Segment Write-Protect bit (General Segment may be written)
#pragma config GCP = OFF                // General Segment Code-Protect bit (General Segment Code protect is Disabled)
