WouterThys/PowerSupply/PIC/Common/DATA_Definitions.h

#ifndef DATA_DEFINITIONS_H
#define	DATA_DEFINITIONS_H

#include <stdint.h>

#define VALUE_LENGTH     6
#define UART_START_CHAR '$'

#define POINT_TO_V       0      /* Point to V   */
#define POINT_TO_I       1      /* Point to I   */
#define SELECT_V         2      /* Select V     */
#define SELECT_I         3      /* Select I     */

#define CMD_NONE         0      /* No data      */
#define CMD_SET_V_SET    1      /* Set voltage  */
#define CMD_SET_I_SET    2      /* Set current  */
#define CMD_SET_V_READ   3      /* Set read V   */
#define CMD_SET_I_READ   4      /* Set read I   */
#define CMD_SET_A_READ   5      /* Set both V&I */

typedef union Command {
    struct {
        uint8_t menu : 2;       // 2 bit menu selection
        uint8_t selected : 1;   // Menu is selected
        uint8_t pointSelect : 2;// Point & select option
        uint8_t command : 3;    // Command
    };
    uint8_t cmd_bits;
} GLCD_Command_t;

typedef struct DataPacket {
    GLCD_Command_t command;
    char * v_set;         // Value for V
    char * i_set;         // Value for I
    char * v_rd;          // Read value for V
    char * i_rd;          // Read value for I
} GLCD_DataPacket_t;

#endif	/* DATA_CONTROLLER_H */
