WouterThys/PowerSupply/PIC/MainController.X/Utils.h

/* 
 * File:   
 * Author: 
 * Comments:
 * Revision history: 
 */

// This is a guard condition so that contents of this file are not included
// more than once.  
#ifndef UTILS_H
#define	UTILS_H

#include <xc.h> // include processor files - each processor file is guarded.  


#define digitalToVoltage(d) ((((float)d * (float)Vref) / ((float)AdcN)) * Vgain)
#define voltageToDigital(v) ((((float)v * (float)DacN) / ((float)Vref)) * (1/Vgain))

#define digitalToCurrent(d) (((((float)d * (float)Vref) / ((float)AdcN)) * 1000) / (Rs * Igain))
#define currentToDigital(i) ()

#define digitalToTemp(d) ((((float)d * (float)Vref) / (float)AdcN)) / ((float)Rt * 1E-6)


bool stringEquals(const char * str1, const char * str2);

uint16_t stringToInt(const char * str);

/**
 * Find the minimum value in an array
 * @param values: the array
 * @param length: length of the array
 * @return index of smallest element
 */
uint16_t minimumValue(float *values, uint16_t length);

/**
 * @param msb 
 * @param lsb
 * @param out
 */
void concatinate(uint8_t msb, uint8_t lsb, uint16_t * out);

/**
 * 
 * @param in
 * @param msb
 * @param lsb
 */
void split(uint16_t in, uint8_t * msb, uint8_t * lsb);

#endif	/* XC_HEADER_TEMPLATE_H */
