WouterThys/PowerSupply/PIC/GLCDTest.X/Controllers/custom_char.h

/* 
 * File:   custom_char.h
 * Author: Avinash
 *
 * Created on 8 June, 2013, 12:23 PM
 */

#ifndef CUSTOM_CHAR_H
#define	CUSTOM_CHAR_H

#ifdef	__cplusplus
extern "C" {
#endif

// TET 1
const unsigned char __costum0 []=
{
	0x00, 0x02, 0x04, 0x04, 0x04, 0x08, 0x08, 0x08, //Char0 bl
	0x00, 0x00, 0x00, 0x00, 0x00, 0x00, 0x00, 0x00, //Char1 bm
	0x00, 0x08, 0x04, 0x04, 0x00, 0x02, 0x02, 0x02, //Char2 br
	0x08, 0x08, 0x08, 0x04, 0x04, 0x02, 0x01, 0x00, //Char3 ol
	0x0E, 0x0A, 0x0E, 0x00, 0x00, 0x00, 0x00, 0x1F, //Char4 om
	0x02, 0x02, 0x04, 0x04, 0x04, 0x08, 0x10, 0x00, //Char5 or
	0x00, 0x00, 0x00, 0x00, 0x00, 0x00, 0x00, 0x00, //Char6
	0x00, 0x00, 0x00, 0x00, 0x00, 0x00, 0x00, 0x00, //Char7
};

// TET 2
const unsigned char __costum1 []=
{
	0x00, 0x02, 0x04, 0x08, 0x08, 0x10, 0x10, 0x10, //Char0 
	0x00, 0x00, 0x00, 0x00, 0x00, 0x00, 0x00, 0x0E, //Char1
	0x00, 0x08, 0x04, 0x02, 0x02, 0x01, 0x01, 0x01, //Char2
	0x10, 0x08, 0x08, 0x04, 0x02, 0x01, 0x00, 0x00, //Char3
	0x0A, 0x0E, 0x00, 0x00, 0x00, 0x00, 0x1F, 0x00, //Char4
	0x01, 0x02, 0x02, 0x04, 0x08, 0x10, 0x00, 0x00, //Char5
	0x00, 0x00, 0x00, 0x00, 0x00, 0x00, 0x00, 0x00, //Char6
	0x00, 0x00, 0x00, 0x00, 0x00, 0x00, 0x00, 0x00, //Char7
};

// TET 3
const unsigned char __costum2 []=
{
	0x00, 0x02, 0x04, 0x04, 0x08, 0x10, 0x10, 0x10, //Char0 
	0x00, 0x00, 0x00, 0x00, 0x00, 0x00, 0x0E, 0x0A, //Char1
	0x00, 0x08, 0x04, 0x04, 0x02, 0x01, 0x01, 0x01, //Char2
	0x08, 0x08, 0x04, 0x02, 0x01, 0x00, 0x00, 0x00, //Char3
	0x0E, 0x00, 0x00, 0x00, 0x00, 0x1F, 0x00, 0x00, //Char4
	0x02, 0x02, 0x04, 0x08, 0x10, 0x00, 0x00, 0x00, //Char5
	0x00, 0x00, 0x00, 0x00, 0x00, 0x00, 0x00, 0x00, //Char6
	0x00, 0x00, 0x00, 0x00, 0x00, 0x00, 0x00, 0x00, //Char7
};

// P nrf
const unsigned char __costum3 []=
{
        0x00, 0x07, 0x0F, 0x0C, 0x0C, 0x0C, 0x0F, 0x0F, // 0
        0x00, 0x10, 0x18, 0x08, 0x08, 0x08, 0x18, 0x10, // 1
        0x00, 0x03, 0x07, 0x0E, 0x0C, 0x0C, 0x0C, 0x0F, // 2
        0x00, 0x10, 0x18, 0x1C, 0x0C, 0x0C, 0x1C, 0x0C, // 3
        0x0C, 0x0C, 0x0C, 0x0C, 0x0C, 0x0C, 0x1E, 0x00, // 4
        0x0A, 0x04, 0x04, 0x0E, 0x0E, 0x0E, 0x0E, 0x00, // 5
        0x0C, 0x0C, 0x0C, 0x0C, 0x0C, 0x0C, 0x1E, 0x00, // 6
        0x0C, 0x0C, 0x0C, 0x0C, 0x0C, 0x0C, 0x1E, 0x00, // 7
};

// nrf A
const unsigned char __costum4 []=
{
        0x00, 0x0A, 0x04, 0x04, 0x07, 0x01, 0x01, 0x01, // 0
        0x00, 0x00, 0x00, 0x00, 0x1E, 0x1E, 0x1E, 0x1E, // 1
        0x00, 0x03, 0x07, 0x0E, 0x0C, 0x0C, 0x0C, 0x0F, // 2
        0x00, 0x10, 0x18, 0x1C, 0x0C, 0x0C, 0x1C, 0x0C, // 3
        0x01, 0x01, 0x01, 0x01, 0x00, 0x00, 0x00, 0x00, // 4
        0x1E, 0x1E, 0x1E, 0x1E, 0x00, 0x00, 0x00, 0x00, // 5
        0x0C, 0x0C, 0x0C, 0x0C, 0x0C, 0x0C, 0x1E, 0x00, // 6
        0x0C, 0x0C, 0x0C, 0x0C, 0x0C, 0x0C, 0x1E, 0x00, // 7
};


unsigned char __HexVal[]=
{
    '0','1','2','3','4','5','6','7','8','9','A','B','C','D','E','F',
};


#ifdef	__cplusplus
}
#endif

#endif	/* CUSTOM_CHAR_H */
