WouterThys/PowerSupply/PIC/GLCDTest.X/Drivers/UserFunctions.h

/* 
 * File:   UserFunctions.h
 * Author: wouter
 *
 * Created on 8 juni 2015, 21:39
 */

#ifndef USERFUNCTIONS_H
#define	USERFUNCTIONS_H

#ifdef	__cplusplus
extern "C" {
#endif

    void DoSomething(uint8_t *);
    void ResetSystem(uint8_t *r);


#ifdef	__cplusplus
}
#endif

#endif	/* USERFUNCTIONS_H */
