WouterThys/PowerSupply/(commit log)

2017-05-12 Added PIC projects and I2C interface
2017-05-14 added lcd driver
2017-05-14 before interrupts driven read
2017-05-14 I2C read and write working
2017-05-14 rotary encoder
2017-05-20 added MCP4131 controll
    [MCP4131_R_Values.ods]
2017-05-25 Bringing it all together
    [MCP4131_R_Values.ods]
2017-07-11 commit uncomitted and add pcb
    [SupplyMainDigital.csv, SupplyMainDigital.kicad_pcb, SupplyMainDigital.sch, VariablePower.sch]
2017-07-11 Change footprints, add serial leds
    [SupplyMainDigital.kicad_pcb]
2017-07-11 component layout done
    [SupplyMainDigital.kicad_pcb, SupplyMainDigital.sch, VariablePower.sch]
2017-07-11 Pcb layout V2 ready
    [SupplyMainDigital.kicad_pcb, SupplyMainDigital.sch]
2017-07-11 lcd pcdb
    [LCD.kicad_pcb, LCD.sch, Power.sch]
2017-12-25 Pic code for variable with correct output pins
    [SupplyMainDigital.sch, VariablePower.sch]
2018-02-17 next pcb version
    [SupplyMainDigital.kicad_pcb, SupplyMainDigital.sch, VariablePower.sch]
2018-02-24 added v2 of variable and lcd board
2018-03-01 better i2c
2018-03-10 basics for pic done
    [ConstantSupply.kicad_pcb, ConstantSupply.sch, SupplyMainDigital.csv, SupplyMainDigital.kicad_pcb, SupplyMainDigital.sch, VariablePower.sch]
2018-03-18 first application + uart api
    [SupplyMainDigital.kicad_pcb, SupplyMainDigital.sch]
2018-03-26 new software, reorden pcb layout
    [ControlBoard.kicad_pcb, ControlBoard.sch, LCD.kicad_pcb, LCD.sch, Power.sch, SupplyMainDigital.sch]
2018-03-26 voltage sweep on new pcb
    [voltageSweep.ods]
2018-05-12 commit before adc refactor
2018-06-11 lcd pcb
    [ControlBoard-2018-06-03-15-35-16.sch, MainController.kicad_pcb, MainController.sch, SimpleSupply-2018-06-02-21-59-01.sch, SupplyMainDigital-2018-06-02-11-19-30.sch, SupplyMainDigital.kicad_pcb, SupplyMainDigital.sch]
2018-06-12 pcb lcd
    [MainController.kicad_pcb, MainController.sch]
2018-06-13 create main pcb
    [MainController.kicad_pcb, MainController.sch]
2018-06-14 clean up main controller pcb
    [MainController.kicad_pcb, MainController.sch]
2018-06-28 unwanted modifs?
    [MainController.kicad_pcb]
2018-07-06 opening mplab
    [MainController.kicad_pcb, MainController.sch]
2018-07-09 updated pcb for MPC23S power supply error
    [MainController.kicad_pcb, MainController.sch]
2018-07-12 encoder other possibilities
2018-07-20 created new projects
    [MainController.kicad_pcb]
2018-07-21 new adc and communication
2018-07-24 add status to i2c communication
2018-07-26 calibrate fsm
2018-07-27 salve i2c with buffer address in stead of command
2018-07-30 menus and calibration
    [MainController.kicad_pcb]
2019-04-15 added description and windows builds
    [MainController.sch, SupplyMainDigital.sch]
2019-04-15 updated some unimportant files
    [MainController.sch, measurements.ods]
2020-04-18 Write to GLCD driver
2020-04-19 Rotary encoder driver
2020-05-08 main glcd controller pcb
    [MainGLCDController.kicad_pcb, MainGLCDController.sch]
